Car-V/CSTAR-capstone/README.md

# CSTAR-capstone
Concrete Sounding Tool Automated Robot for EECE4792 Capstone 2
