Car-V/CSTAR-capstone/Software_Layout/High Level Overview.pdf

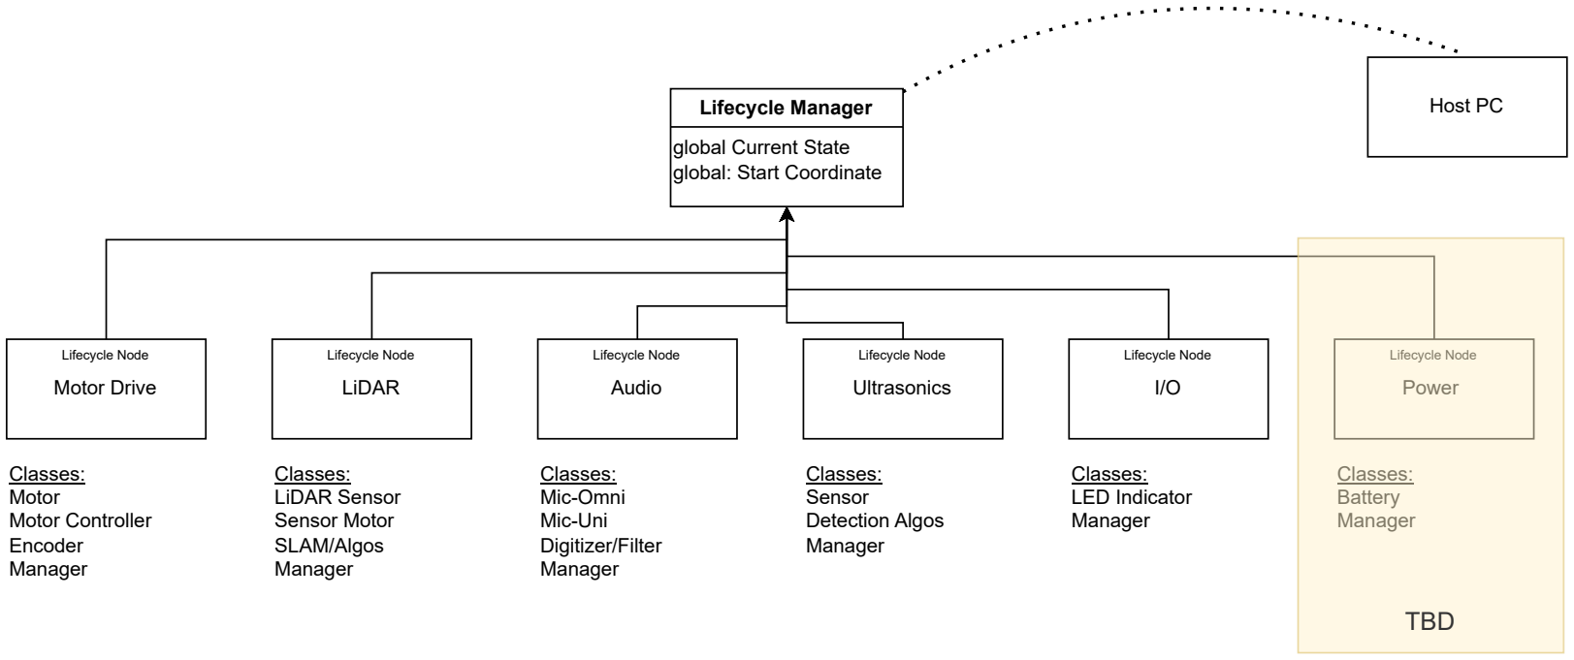
[picture p1: figure]
Motor Drive; LiDAR; Audio; Ultrasonics; Power; Lifecycle Manager; Host PC; global Current State global: Start Coordinate; Lifecycle Node; Classes: Motor Motor Controller Encoder Manager; Classes: LiDAR Sensor Sensor Motor SLAM/Algos Manager; Classes: Mic-Omni Mic-Uni Digitizer/Filter Manager; Classes: Sensor Detection Algos Manager; Classes: LED Indicator Manager; Classes: Battery Manager; TBD

# What Should All Subsystems Be Aware Of?

Current State (Possibly int with value of 1, 2, or 3?)

Starting Point Coordinates

Determined by:
Status of all subsystems
Network Connection
Connection with Host
