Car-V/CSTAR-capstone/Software_Layout/LiDAR/frames_2025-02-05_11.53.08.pdf

view_frames Result

Recorded at time: 1738774388.4656897

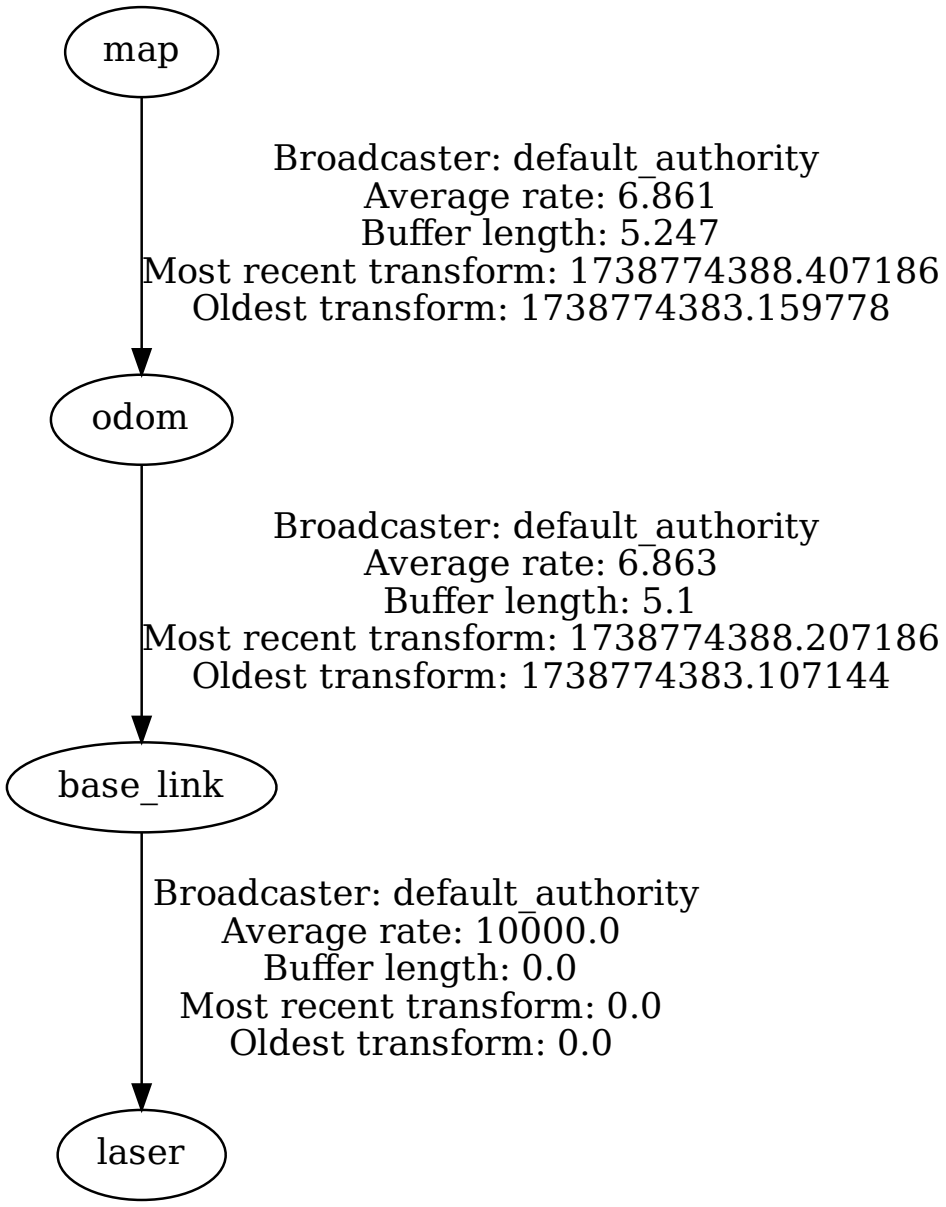
[picture p2: figure]
map; odom; Broadcaster: default_authority Average rate: 6.861 Buffer length: 5.247 Most recent transform: 1738774388.407186 Oldest transform: 1738774383.159778; base_link; Broadcaster: default_authority Average rate: 6.863 Buffer length: 5.1 Most recent transform: 1738774388.207186 Oldest transform: 1738774383.107144; laser; Broadcaster: default_authority Average rate: 10000.0 Buffer length: 0.0 Most recent transform: 0.0 Oldest transform: 0.0
