Car-V/CSTAR-capstone/Software_Layout/LiDAR/frames_2025-02-05_11.55.34.pdf

view_frames Result

Recorded at time: 1738774534.904796

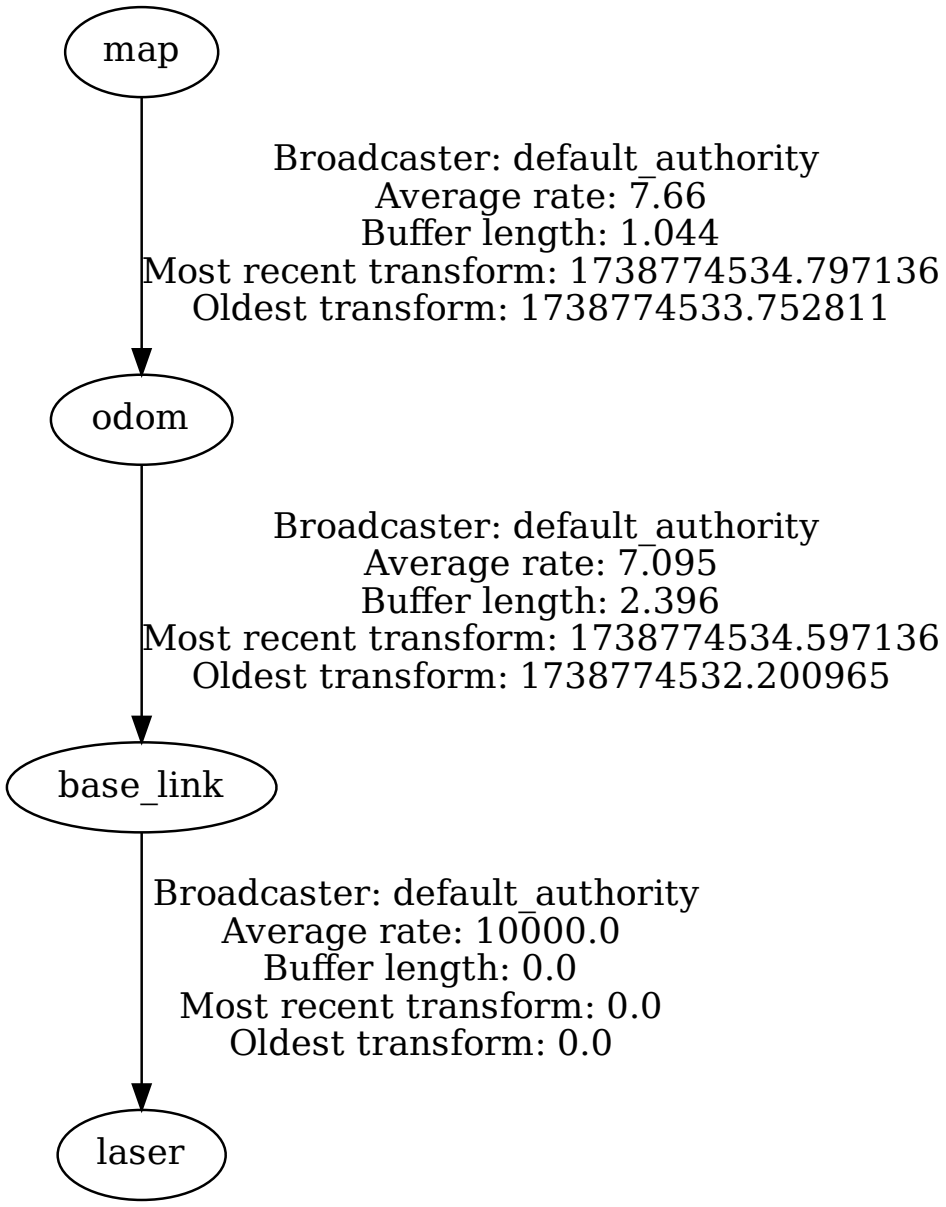
[picture p3: figure]
base_link; laser; Broadcaster: default_authority Average rate: 10000.0 Buffer length: 0.0 Most recent transform: 0.0 Oldest transform: 0.0; odom; Broadcaster: default_authority Average rate: 7.095 Buffer length: 2.396 Most recent transform: 1738774534.597136 Oldest transform: 1738774532.200965; map; Broadcaster: default_authority Average rate: 7.66 Buffer length: 1.044 Most recent transform: 1738774534.797136 Oldest transform: 1738774533.752811
