Car-V/CSTAR-capstone/PCB_Rev1/Main_Board_Rev1/Components/CAD/USB4125-GF-A_REVA2.step

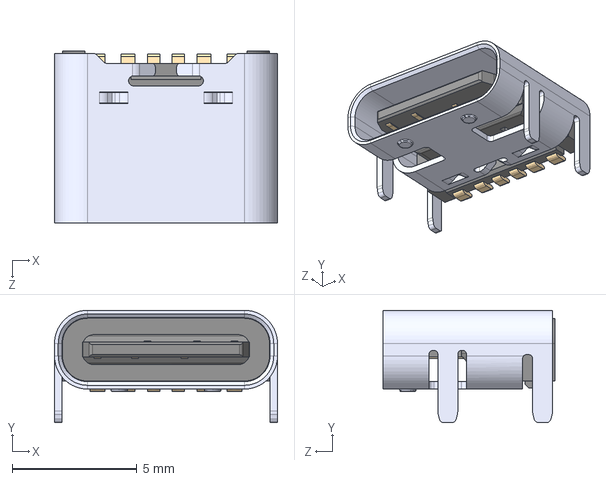
[picture p4: CAD file, 2025-01-22]
PCB_Rev1/Main_Board_Rev1/Components/CAD/USB4125-GF-A_REVA2.step
8.94 x 4.51 x 6.90 mm
