Car-V/CSTAR-capstone/PCB_Rev1/Main_Board_Rev1/Components/CAD/Omnidirectional.step

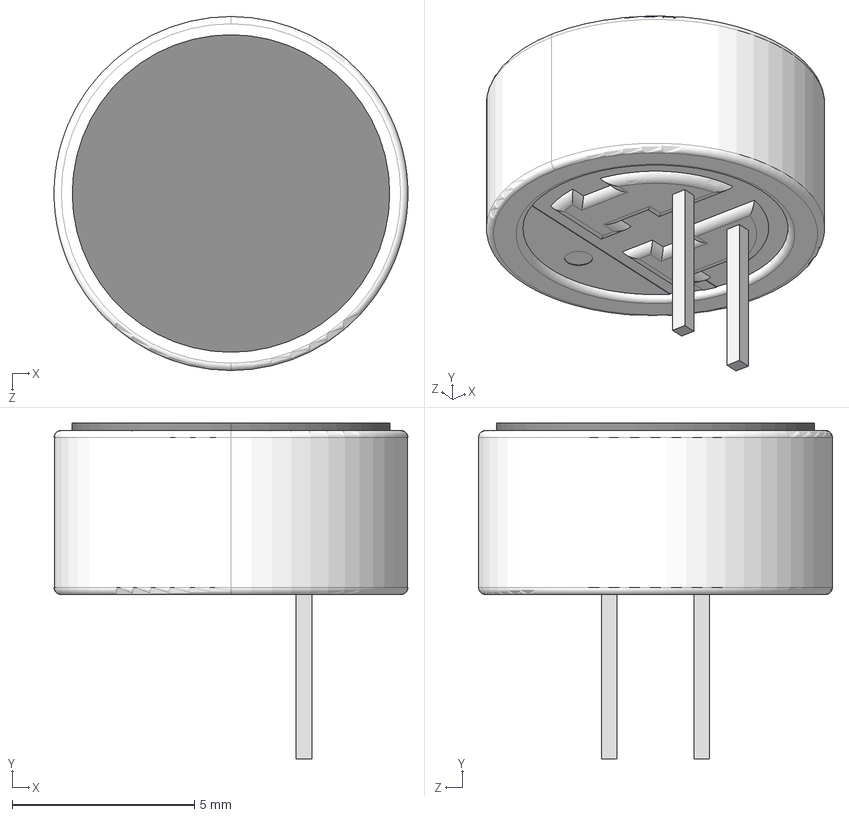
[picture p5: CAD file, 2025-01-15]
PCB_Rev1/Main_Board_Rev1/Components/CAD/Omnidirectional.step
9.70 x 9.20 x 9.70 mm
