Car-V/CSTAR-capstone/(list of files, cad)

Other CAD files:
PCB_Rev1/Components/CAD/Omnidirectional.step
