Car-V/CSTAR-capstone/JLC_ordering_Rev1_1-26/JLC_PCB_order_confirmation.pdf

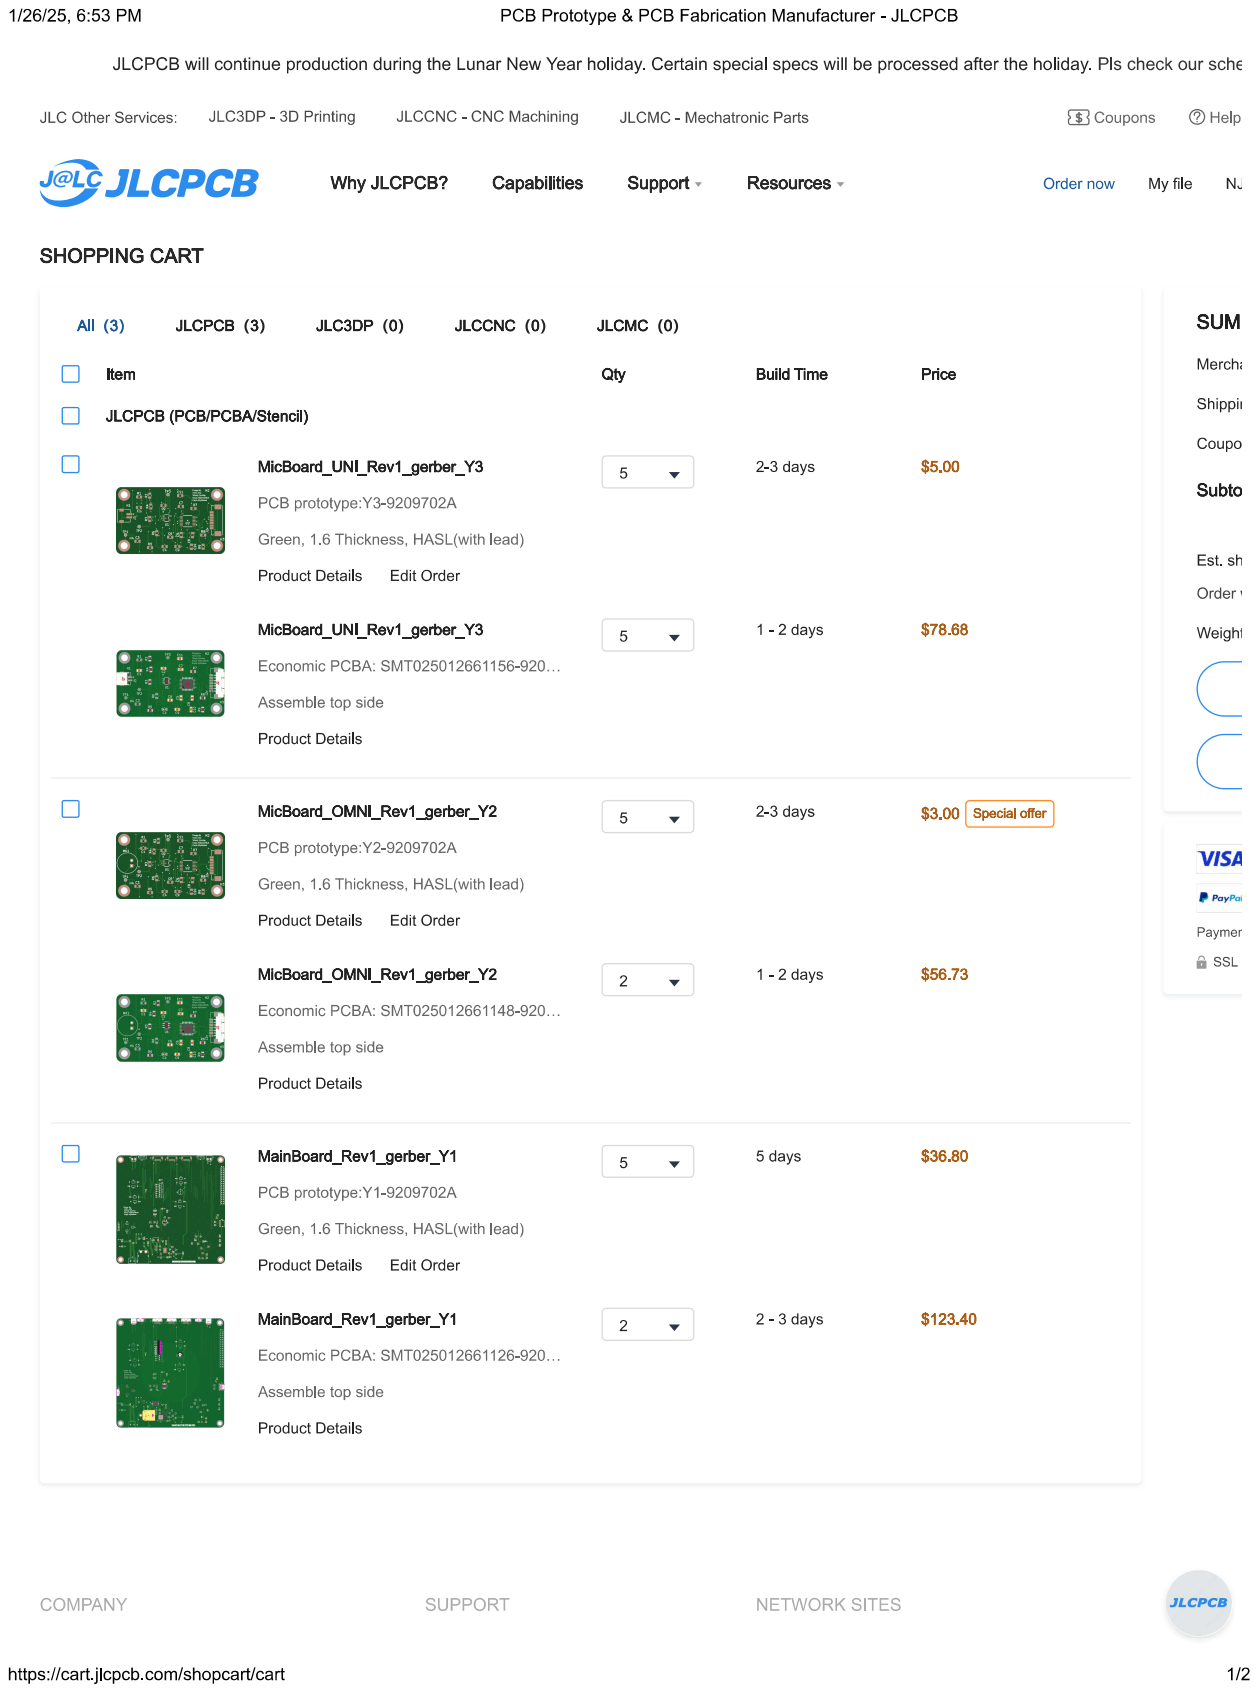
[picture p9: page 1]

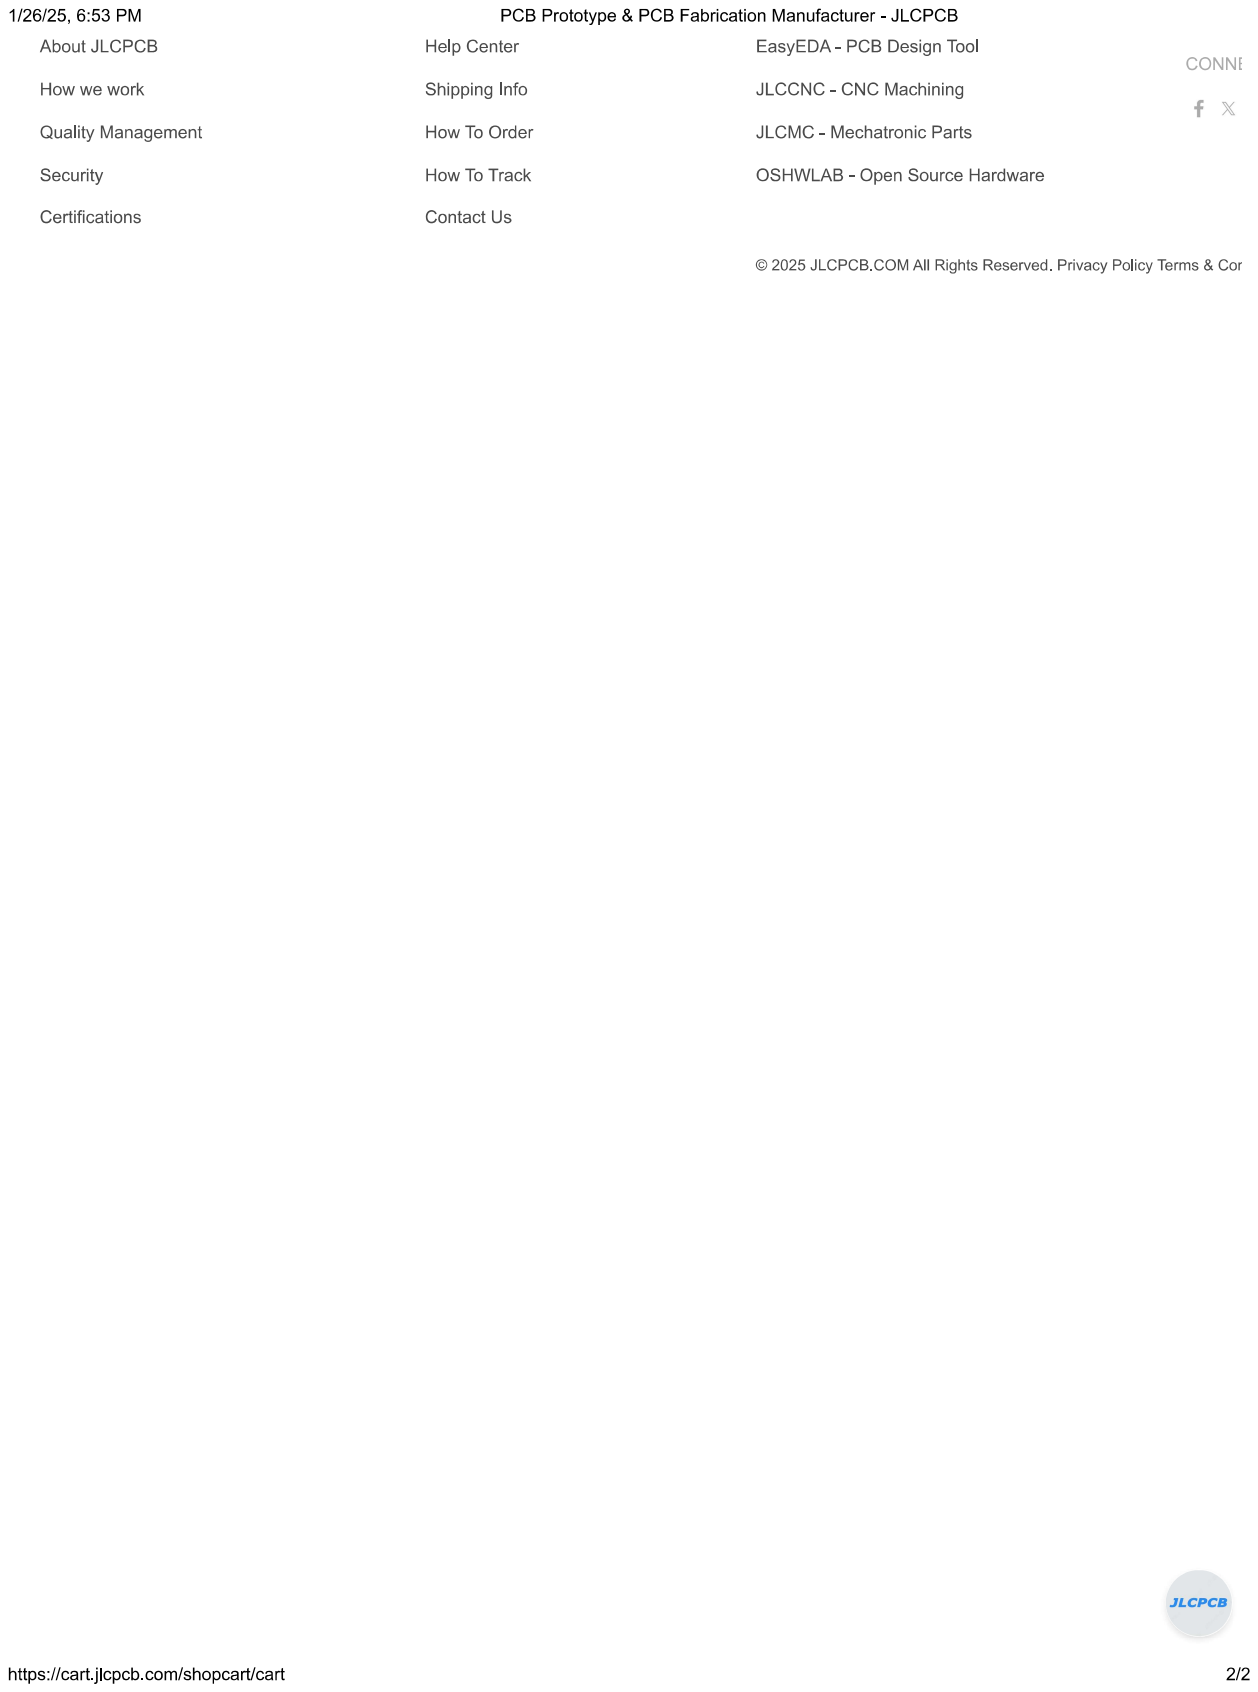
[picture p10: page 2]
