Car-V/CSTAR-capstone/PCB_Rev1/Mic_Board_Omni_NEW/Mic_Board_Omni_NEW.kicad_pcb

## KiCad design PCB_Rev1/Mic_Board_Omni_NEW/Mic_Board_Omni_NEW.kicad_pcb (2025-01-27)

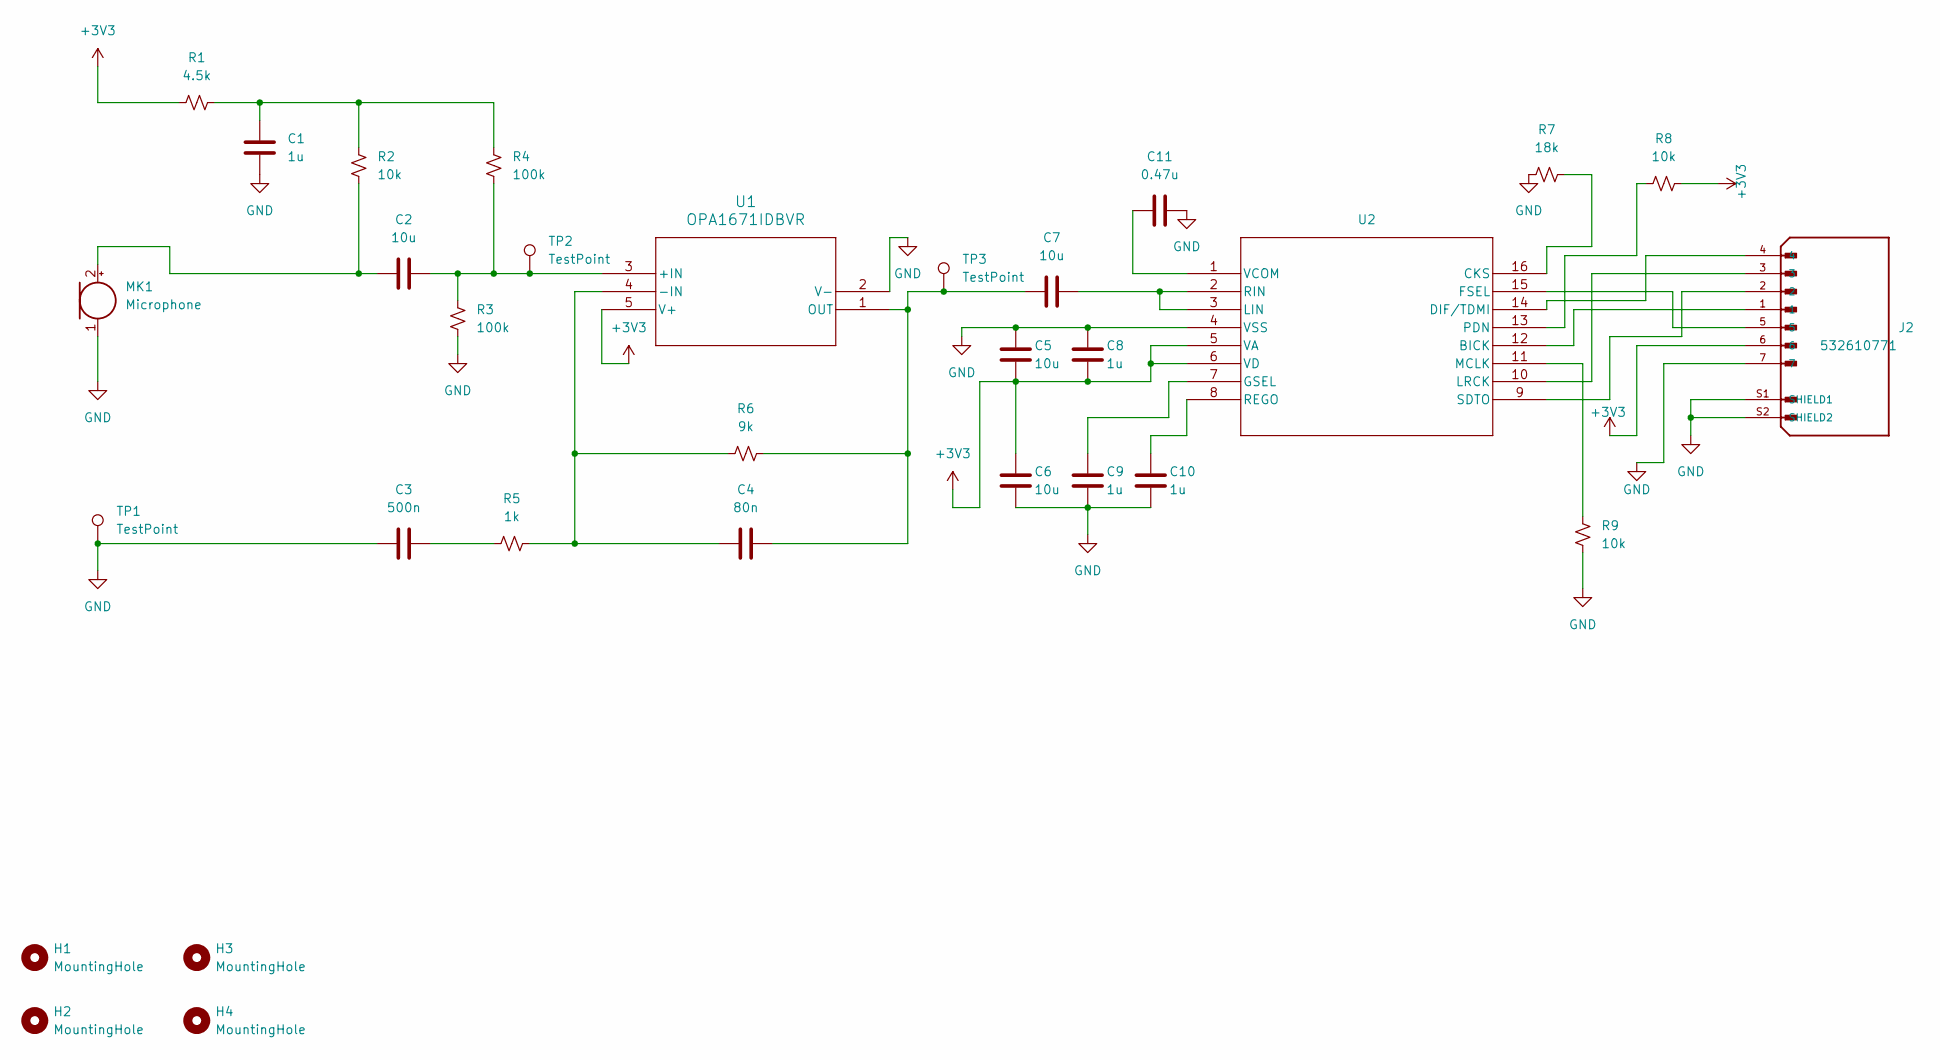
[picture p11: schematic Mic_Board_Omni_NEW.kicad_sch]

Parts:
C1, C8, C9, C10: 1u; C_0805_2012Metric; LCSC C519973
C2, C5, C6, C7: 10u; C_0805_2012Metric; LCSC C88484
C3: 500n; C_0805_2012Metric; LCSC C576434
C4: 80n; C_0805_2012Metric; LCSC C3857194
C11: 0.47u; C_0805_2012Metric; LCSC C519977
H1, H2, H3, H4: MountingHole; MountingHole_3.2mm_M3
J2: 532610771; MOLEX_connector; PARTREV J; DigiKey_Part_Number WM7625TR-ND
MK1: Microphone; Omnidirectional; LCSC C3273770
R1: 4.5k; R_0805_2012Metric; LCSC C865529
R2, R8, R9: 10k; R_0805_2012Metric; LCSC C110775
R3, R4: 100k; R_0805_2012Metric; LCSC C96346
R5: 1k; R_0805_2012Metric; LCSC C95781
R6: 9k; R_0805_2012Metric; LCSC C868262
R7: 18k; R_0805_2012Metric; LCSC C137468
TP1, TP2, TP3: TestPoint; TestPoint_Pad_D1.0mm
U1: OPA1671IDBVR; Op-Amp; LCSC C1849409
U2: ADC; LCSC C1519002

Connections:
+3V3: C5.2, C6.1, C8.2, J2.6, R1.2, R8.2, U1.5 (V+), U2.5 (VA), U2.6 (VD)
GND: C1.2, C3.1, C5.1, C6.2, C8.1, C9.2, C10.2, C11.2, H1.1, H2.1, H3.1, H4.1, J2.7, J2.S1 (SHIELD1), J2.S2 (SHIELD2), MK1.1 (-), R3.2, R7.1, R9.1, TP1.1, U1.2 (V-), U2.4 (VSS)
unnamed: C1.1, R1.1, R2.1, R4.1
unnamed: C3.2, R5.2
unnamed: C2.1, MK1.2 (+), R2.2
unnamed: C2.2, R3.1, R4.2, TP2.1, U1.3 (+IN)
unnamed: C4.1, R5.1, R6.2, U1.4 (-IN)
unnamed: C4.2, C7.1, R6.1, TP3.1, U1.1 (OUT)
unnamed: J2.1, U2.12 (BICK)
unnamed: R7.2, U2.16 (CKS)
unnamed: J2.4, U2.14 (DIF/TDMI)
unnamed: J2.5, U2.15 (FSEL)
unnamed: C9.1, U2.7 (GSEL)
unnamed: C7.2, U2.2 (RIN), U2.3 (LIN)
unnamed: J2.3, U2.10 (LRCK)
unnamed: R9.2, U2.11 (MCLK)
unnamed: R8.1, U2.13 (PDN)
unnamed: C10.1, U2.8 (REGO)
unnamed: J2.2, U2.9 (SDTO)
unnamed: C11.1, U2.1 (VCOM)

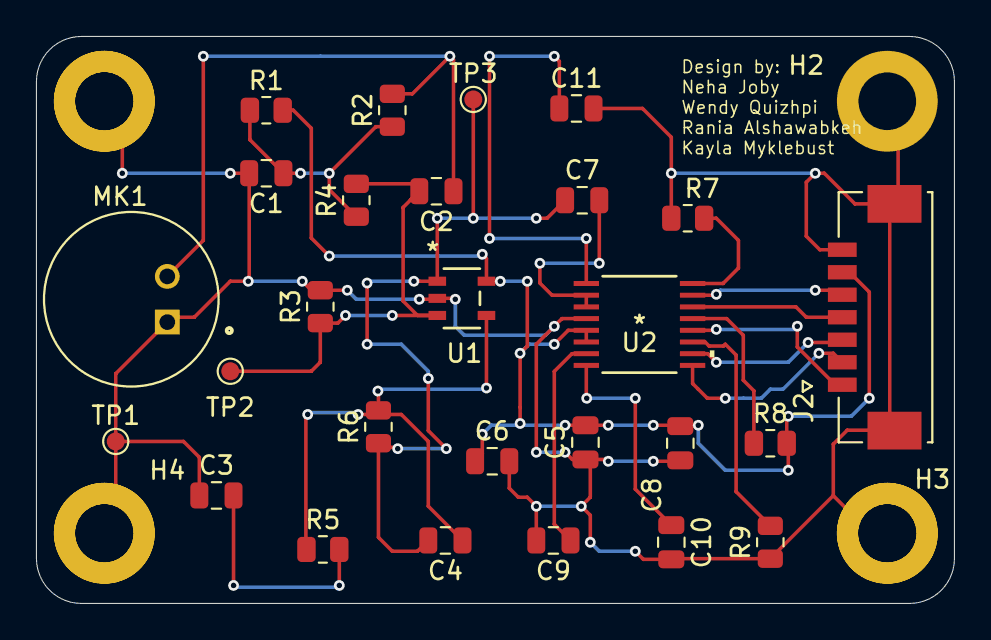
[picture p12: board Mic_Board_Omni_NEW.kicad_pcb from above]

Board: 2 copper layers, 51.0 x 31.5 mm, 31 parts (0 on the bottom side), 20 nets.
