Car-V/CSTAR-capstone/PCB_Rev1/Main_Board_Rev1/Main_Board_Rev1.kicad_pcb

## KiCad design PCB_Rev1/Main_Board_Rev1/Main_Board_Rev1.kicad_pcb (2025-01-26)

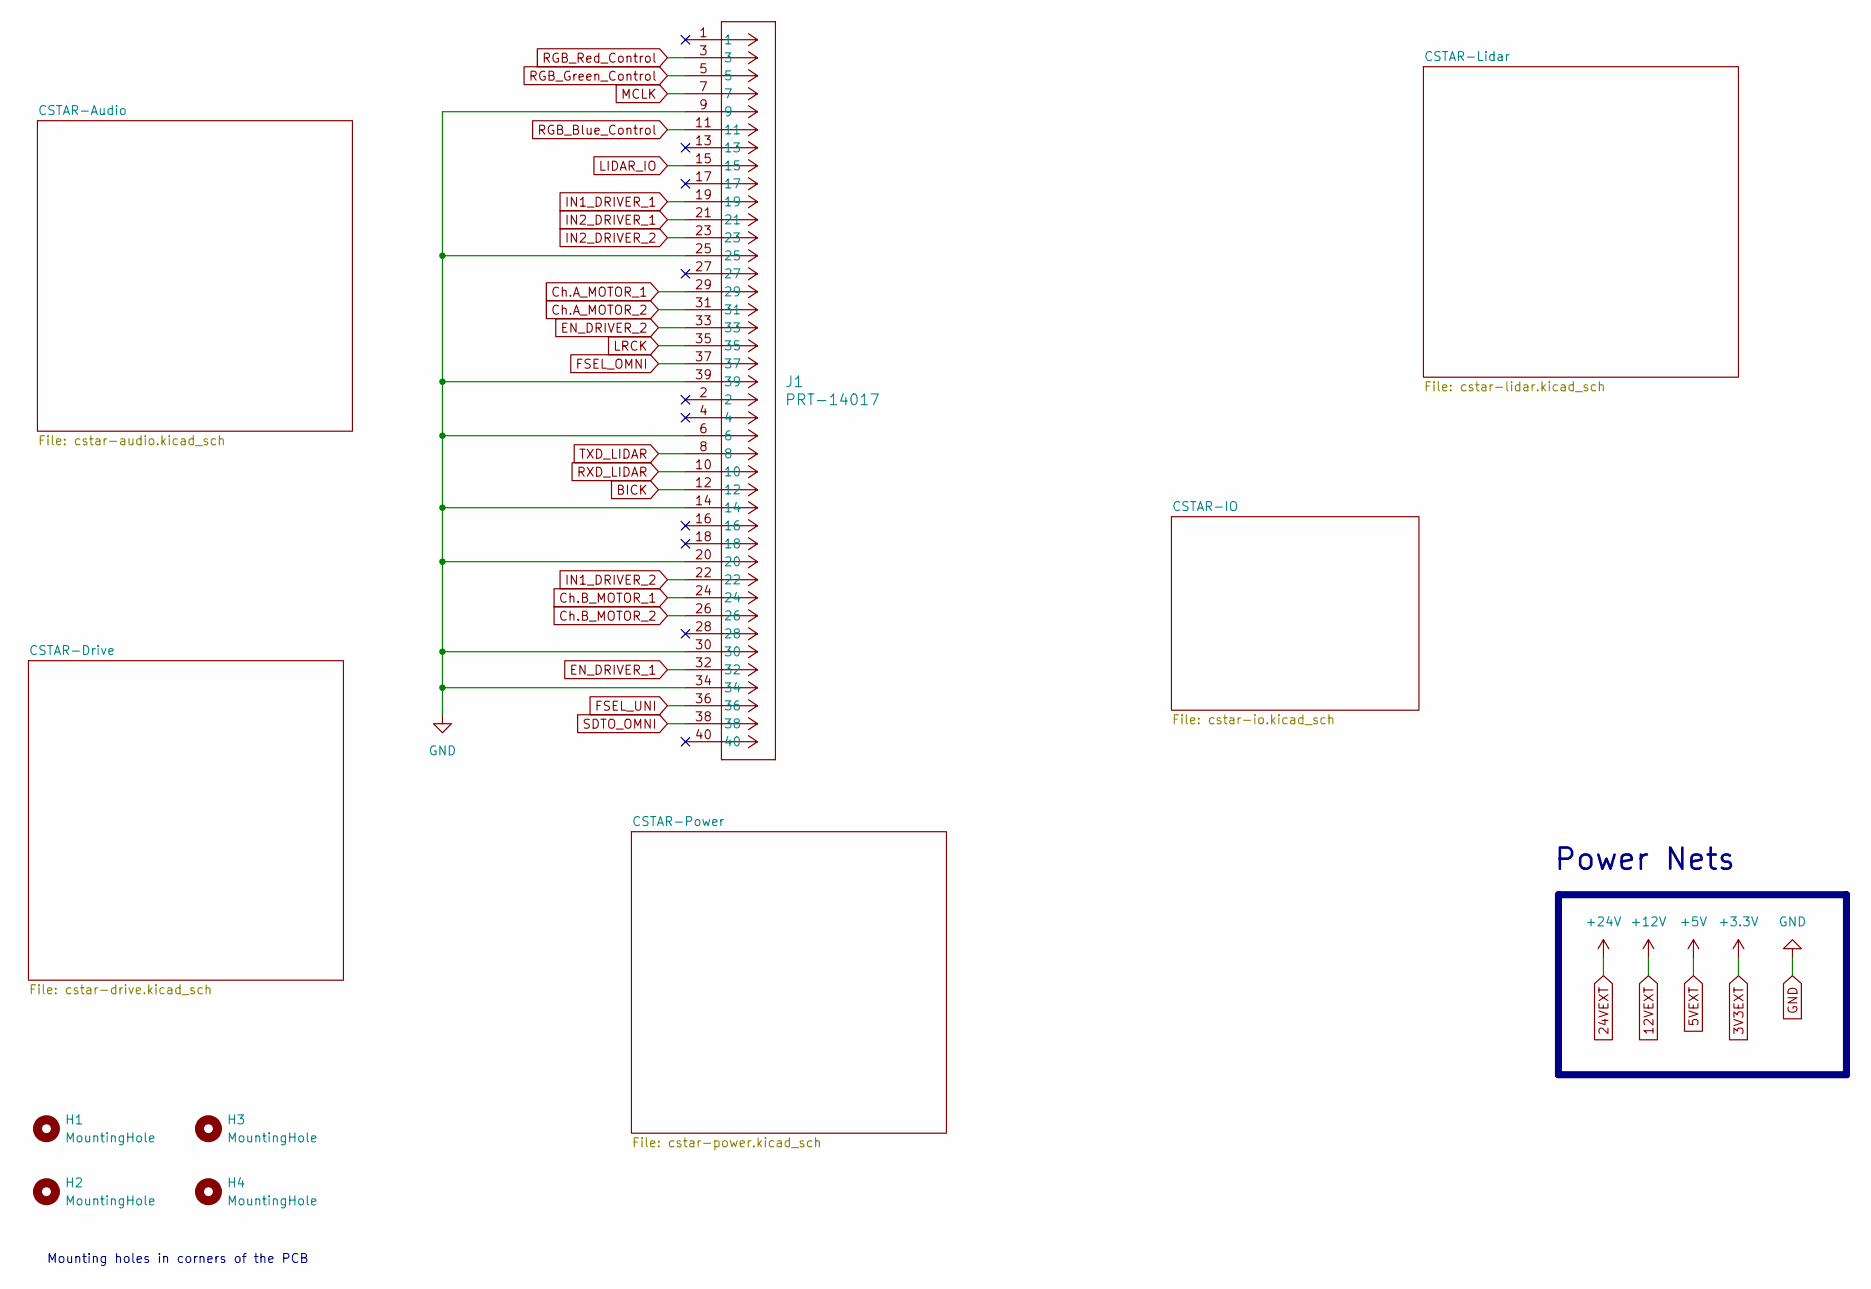
[picture p13: schematic Main_Board_Rev1.kicad_sch]

Parts:
H1, H2, H3, H4: MountingHole; MountingHole_5.3mm_M5_DIN965_Pad
J1: PRT-14017; RPiConnector; LCSC C2859067

Connections:
BICK: J1.12; also elsewhere on the board
Ch.A_MOTOR_1: J1.29; also elsewhere on the board
Ch.A_MOTOR_2: J1.31; also elsewhere on the board
Ch.B_MOTOR_1: J1.24; also elsewhere on the board
Ch.B_MOTOR_2: J1.26; also elsewhere on the board
EN_DRIVER_1: J1.32; also elsewhere on the board
EN_DRIVER_2: J1.33; also elsewhere on the board
FSEL_OMNI: J1.37; also elsewhere on the board
FSEL_UNI: J1.36; also elsewhere on the board
GND: J1.6, J1.9, J1.14, J1.20, J1.25, J1.30, J1.34, J1.39; also elsewhere on the board
IN1_DRIVER_1: J1.19; also elsewhere on the board
IN1_DRIVER_2: J1.22; also elsewhere on the board
IN2_DRIVER_1: J1.21; also elsewhere on the board
IN2_DRIVER_2: J1.23; also elsewhere on the board
LIDAR_IO: J1.15; also elsewhere on the board
LRCK: J1.35; also elsewhere on the board
MCLK: J1.7; also elsewhere on the board
RGB_Blue_Control: J1.11; also elsewhere on the board
RGB_Green_Control: J1.5; also elsewhere on the board
RGB_Red_Control: J1.3; also elsewhere on the board
RXD_LIDAR: J1.10; also elsewhere on the board
SDTO_OMNI: J1.38; also elsewhere on the board
TXD_LIDAR: J1.8; also elsewhere on the board

Notes on the sheet:
Power Nets
Mounting holes in corners of the PCB

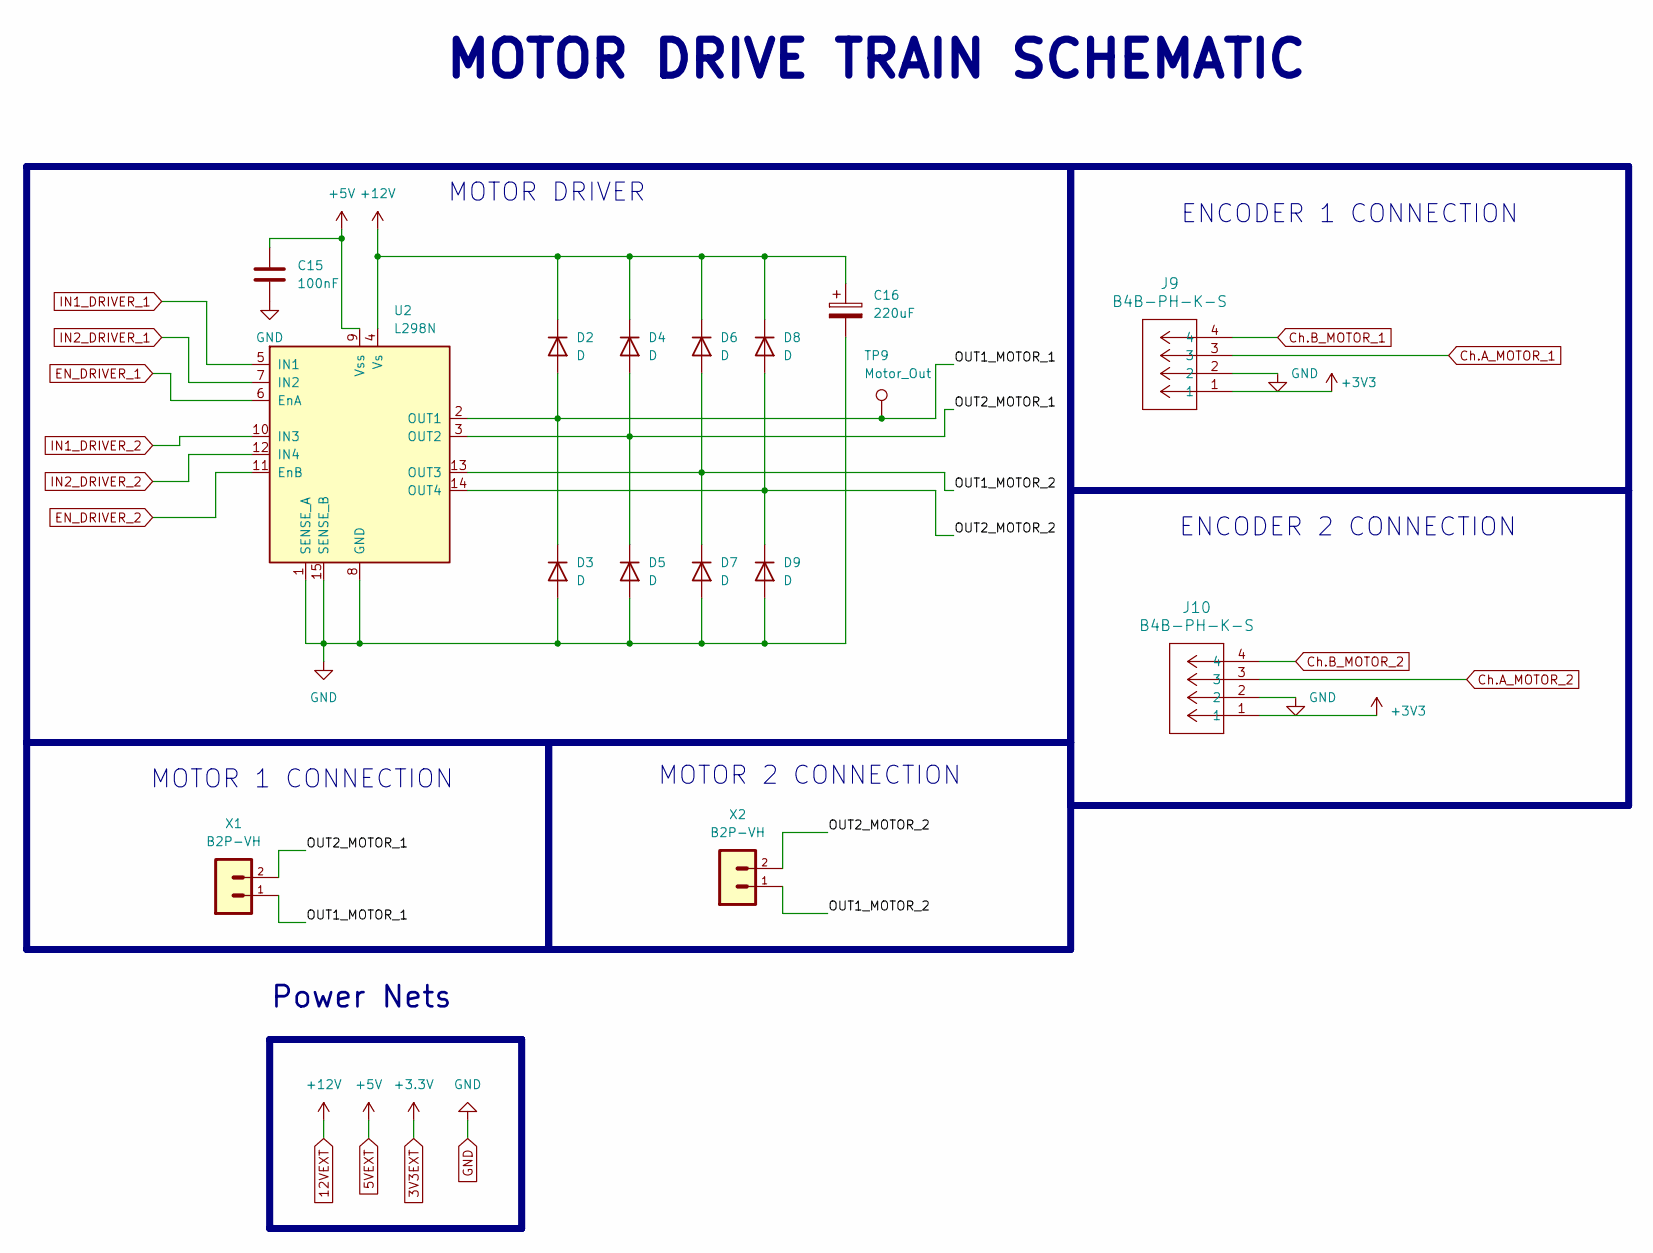
[picture p14: schematic cstar-drive.kicad_sch]

Parts:
C15: 100nF; C_0805_2012Metric; LCSC C520083
C16: 220uF; Cap_Polarized_220uF; LCSC C88729
D2, D3, D4, D5, D6, D7, D8, D9: D; Diode_1N4007; LCSC C516593
J9, J10: B4B-PH-K-S; B4B_PH_K_S; LCSC C305985
TP9: Motor_Out; TestPoint_Pad_D2.0mm
U2: L298N; TO-220-15_P2.54x2.54mm_StaggerOdd_Lead4.58mm_Vertical; LCSC C19922
X1, X2: B2P-VH; LCSC C160315

Connections:
5VEXT: C15.1, U2.9 (Vss); also elsewhere on the board
12VEXT: C16.1, D2.1 (K), D4.1 (K), D6.1 (K), D8.1 (K), U2.4 (Vs); also elsewhere on the board
+3V3: J9.1, J10.1; also elsewhere on the board
/CSTAR-Drive/OUT1_MOTOR_1: D2.2 (A), D3.1 (K), TP9.1, U2.2 (OUT1), X1.1
/CSTAR-Drive/OUT1_MOTOR_2: D6.2 (A), D7.1 (K), U2.13 (OUT3), X2.1
/CSTAR-Drive/OUT2_MOTOR_1: D4.2 (A), D5.1 (K), U2.3 (OUT2), X1.2
/CSTAR-Drive/OUT2_MOTOR_2: D8.2 (A), D9.1 (K), U2.14 (OUT4), X2.2
Ch.A_MOTOR_1: J9.3; also elsewhere on the board
Ch.A_MOTOR_2: J10.3; also elsewhere on the board
Ch.B_MOTOR_1: J9.4; also elsewhere on the board
Ch.B_MOTOR_2: J10.4; also elsewhere on the board
EN_DRIVER_1: U2.6 (EnA); also elsewhere on the board
EN_DRIVER_2: U2.11 (EnB); also elsewhere on the board
GND: C15.2, C16.2, D3.2 (A), D5.2 (A), D7.2 (A), D9.2 (A), J9.2, J10.2, U2.1 (SENSE_A), U2.8 (GND), U2.15 (SENSE_B); also elsewhere on the board
IN1_DRIVER_1: U2.5 (IN1); also elsewhere on the board
IN1_DRIVER_2: U2.10 (IN3); also elsewhere on the board
IN2_DRIVER_1: U2.7 (IN2); also elsewhere on the board
IN2_DRIVER_2: U2.12 (IN4); also elsewhere on the board

Notes on the sheet:
MOTOR 2 CONNECTION
Power Nets
MOTOR 1 CONNECTION
MOTOR DRIVER
ENCODER 1 CONNECTION
ENCODER 2 CONNECTION
MOTOR DRIVE TRAIN SCHEMATIC

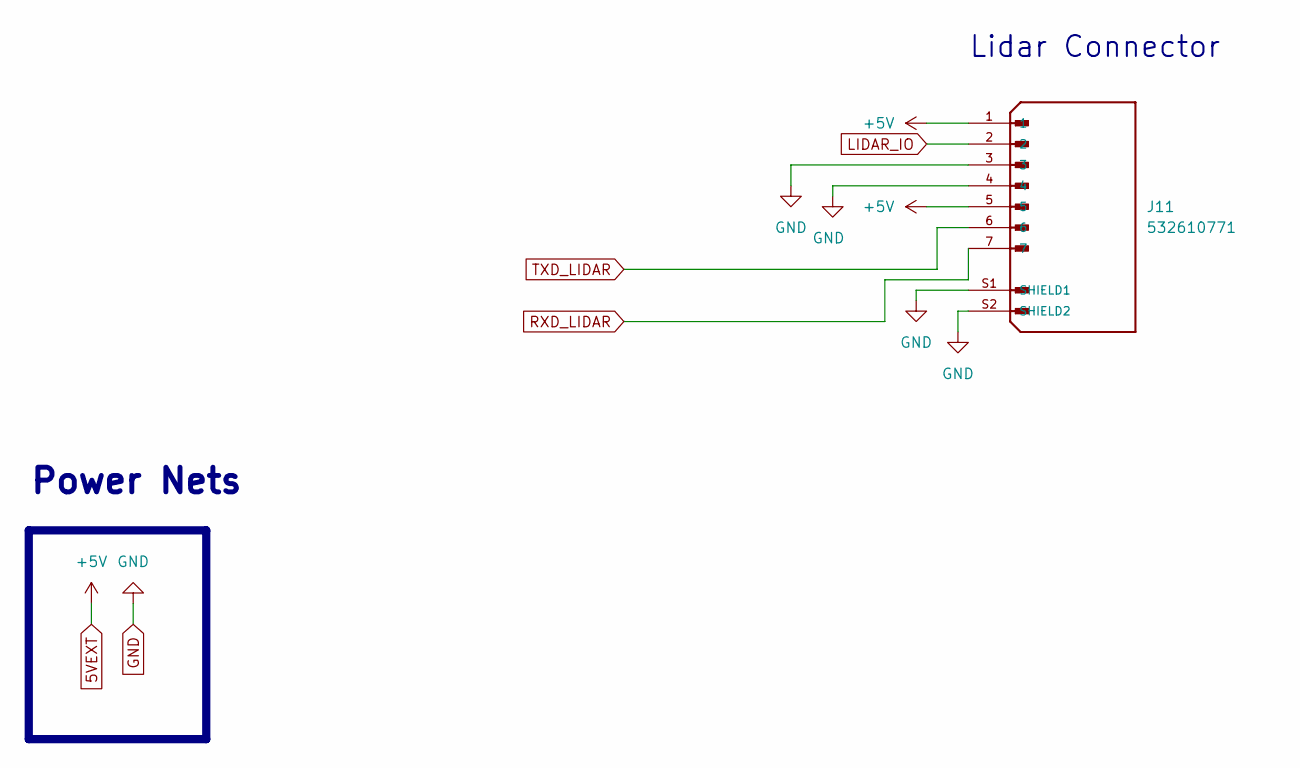
[picture p15: schematic cstar-lidar.kicad_sch]

Parts:
J11: 532610771; MOLEX_connector; PARTREV J; DigiKey_Part_Number WM7625TR-ND

Connections:
5VEXT: J11.1, J11.5; also elsewhere on the board
GND: J11.3, J11.4, J11.S1 (SHIELD1), J11.S2 (SHIELD2); also elsewhere on the board
LIDAR_IO: J11.2; also elsewhere on the board
RXD_LIDAR: J11.7; also elsewhere on the board
TXD_LIDAR: J11.6; also elsewhere on the board

Notes on the sheet:
Lidar Connector
Power Nets

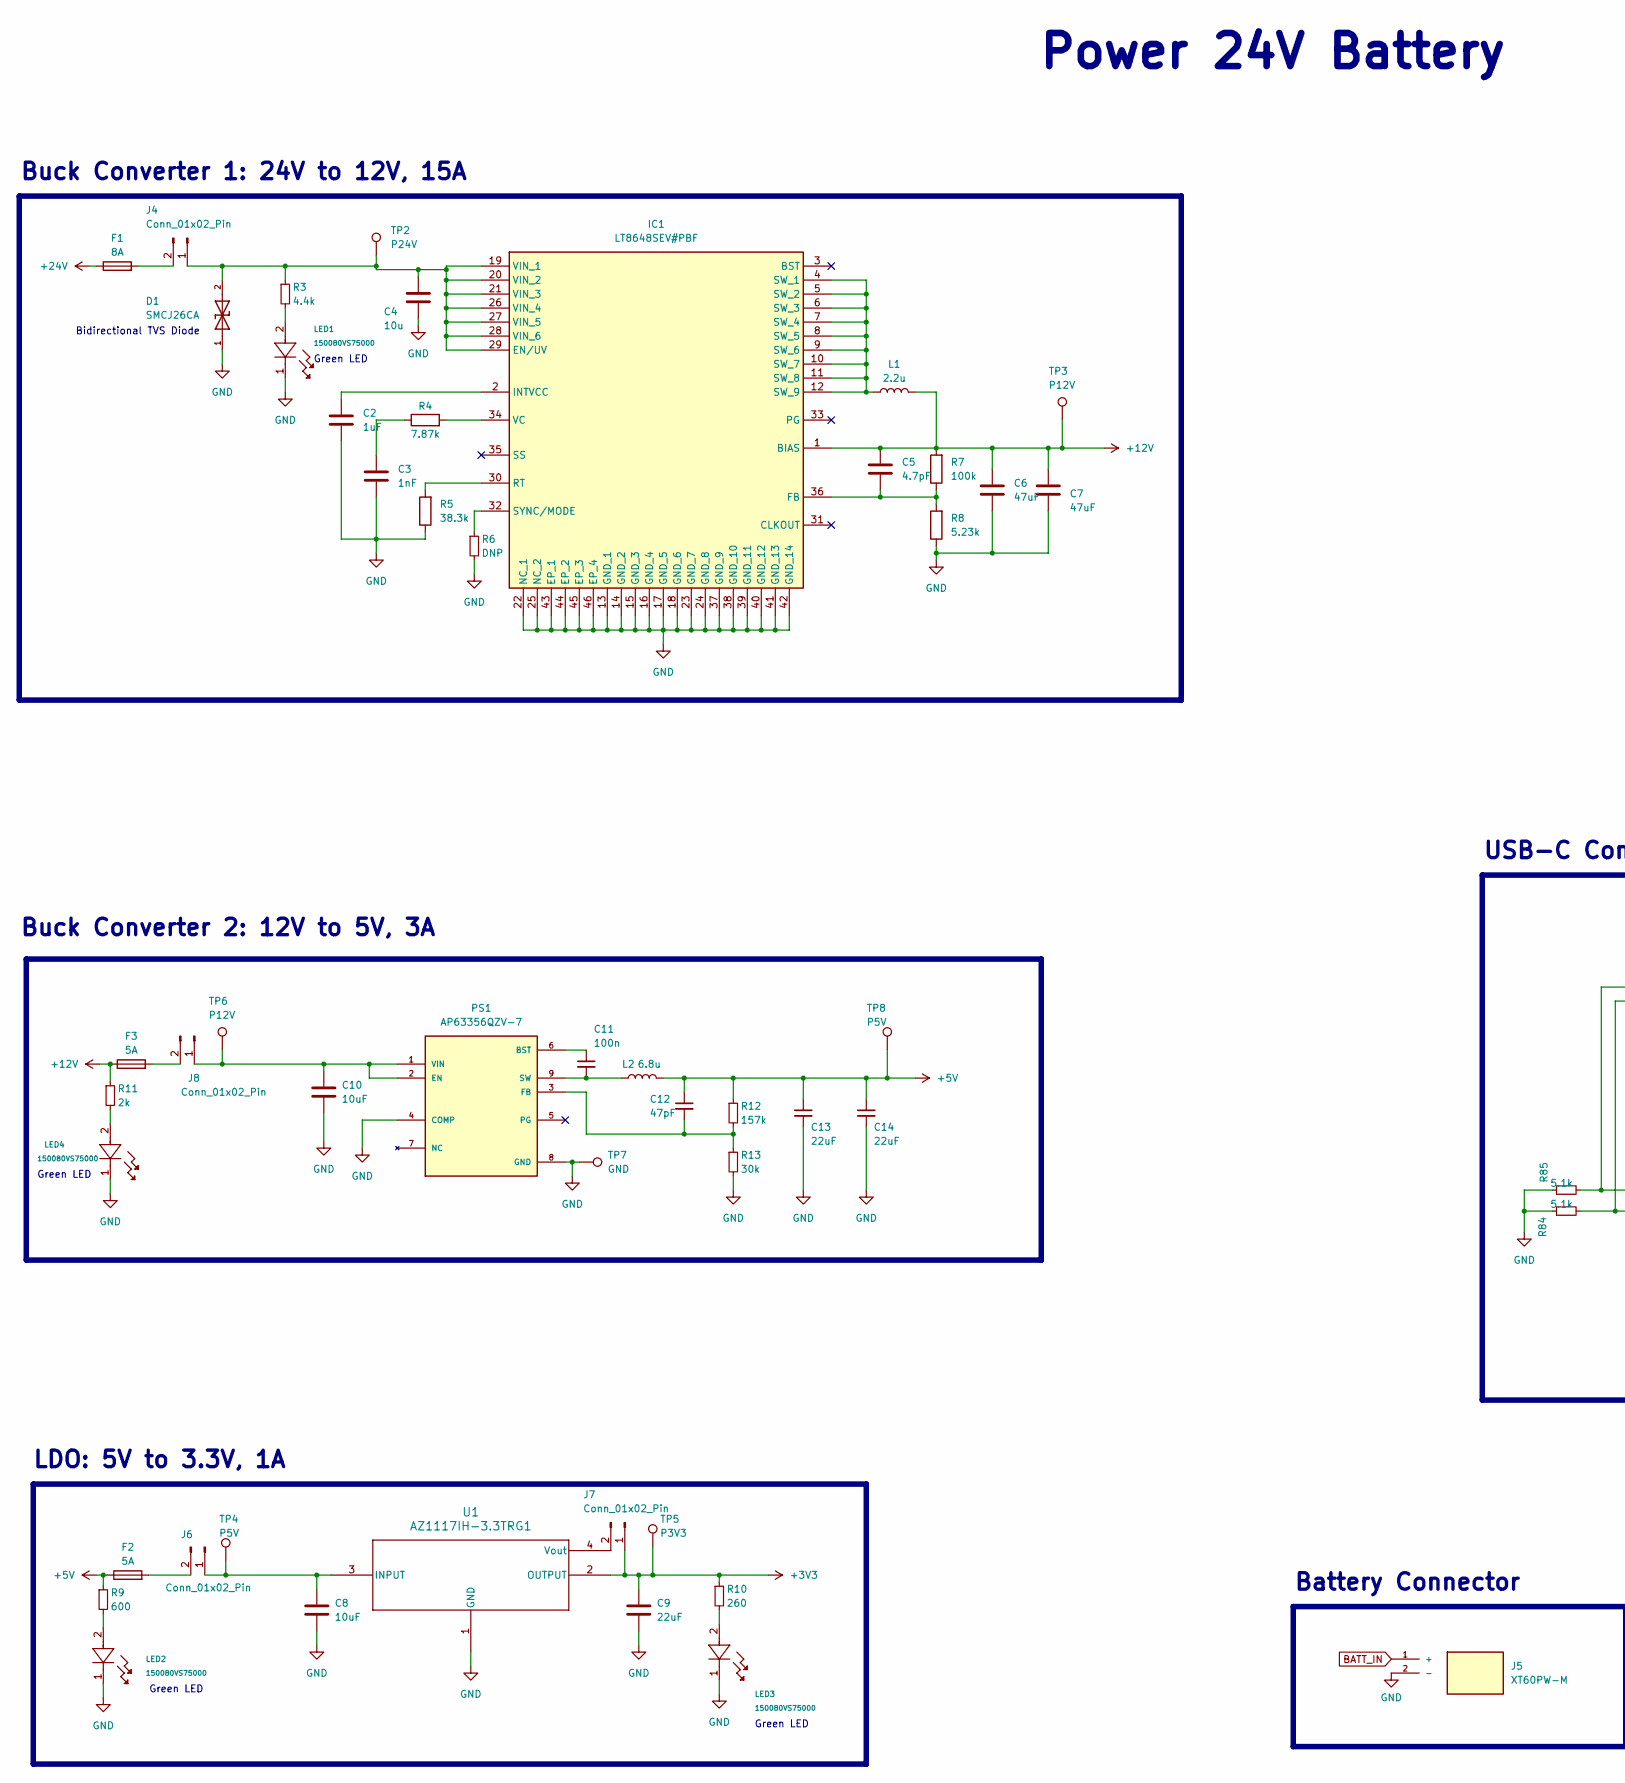
[picture p16: schematic cstar-power.kicad_sch, part in row 1, column 1]

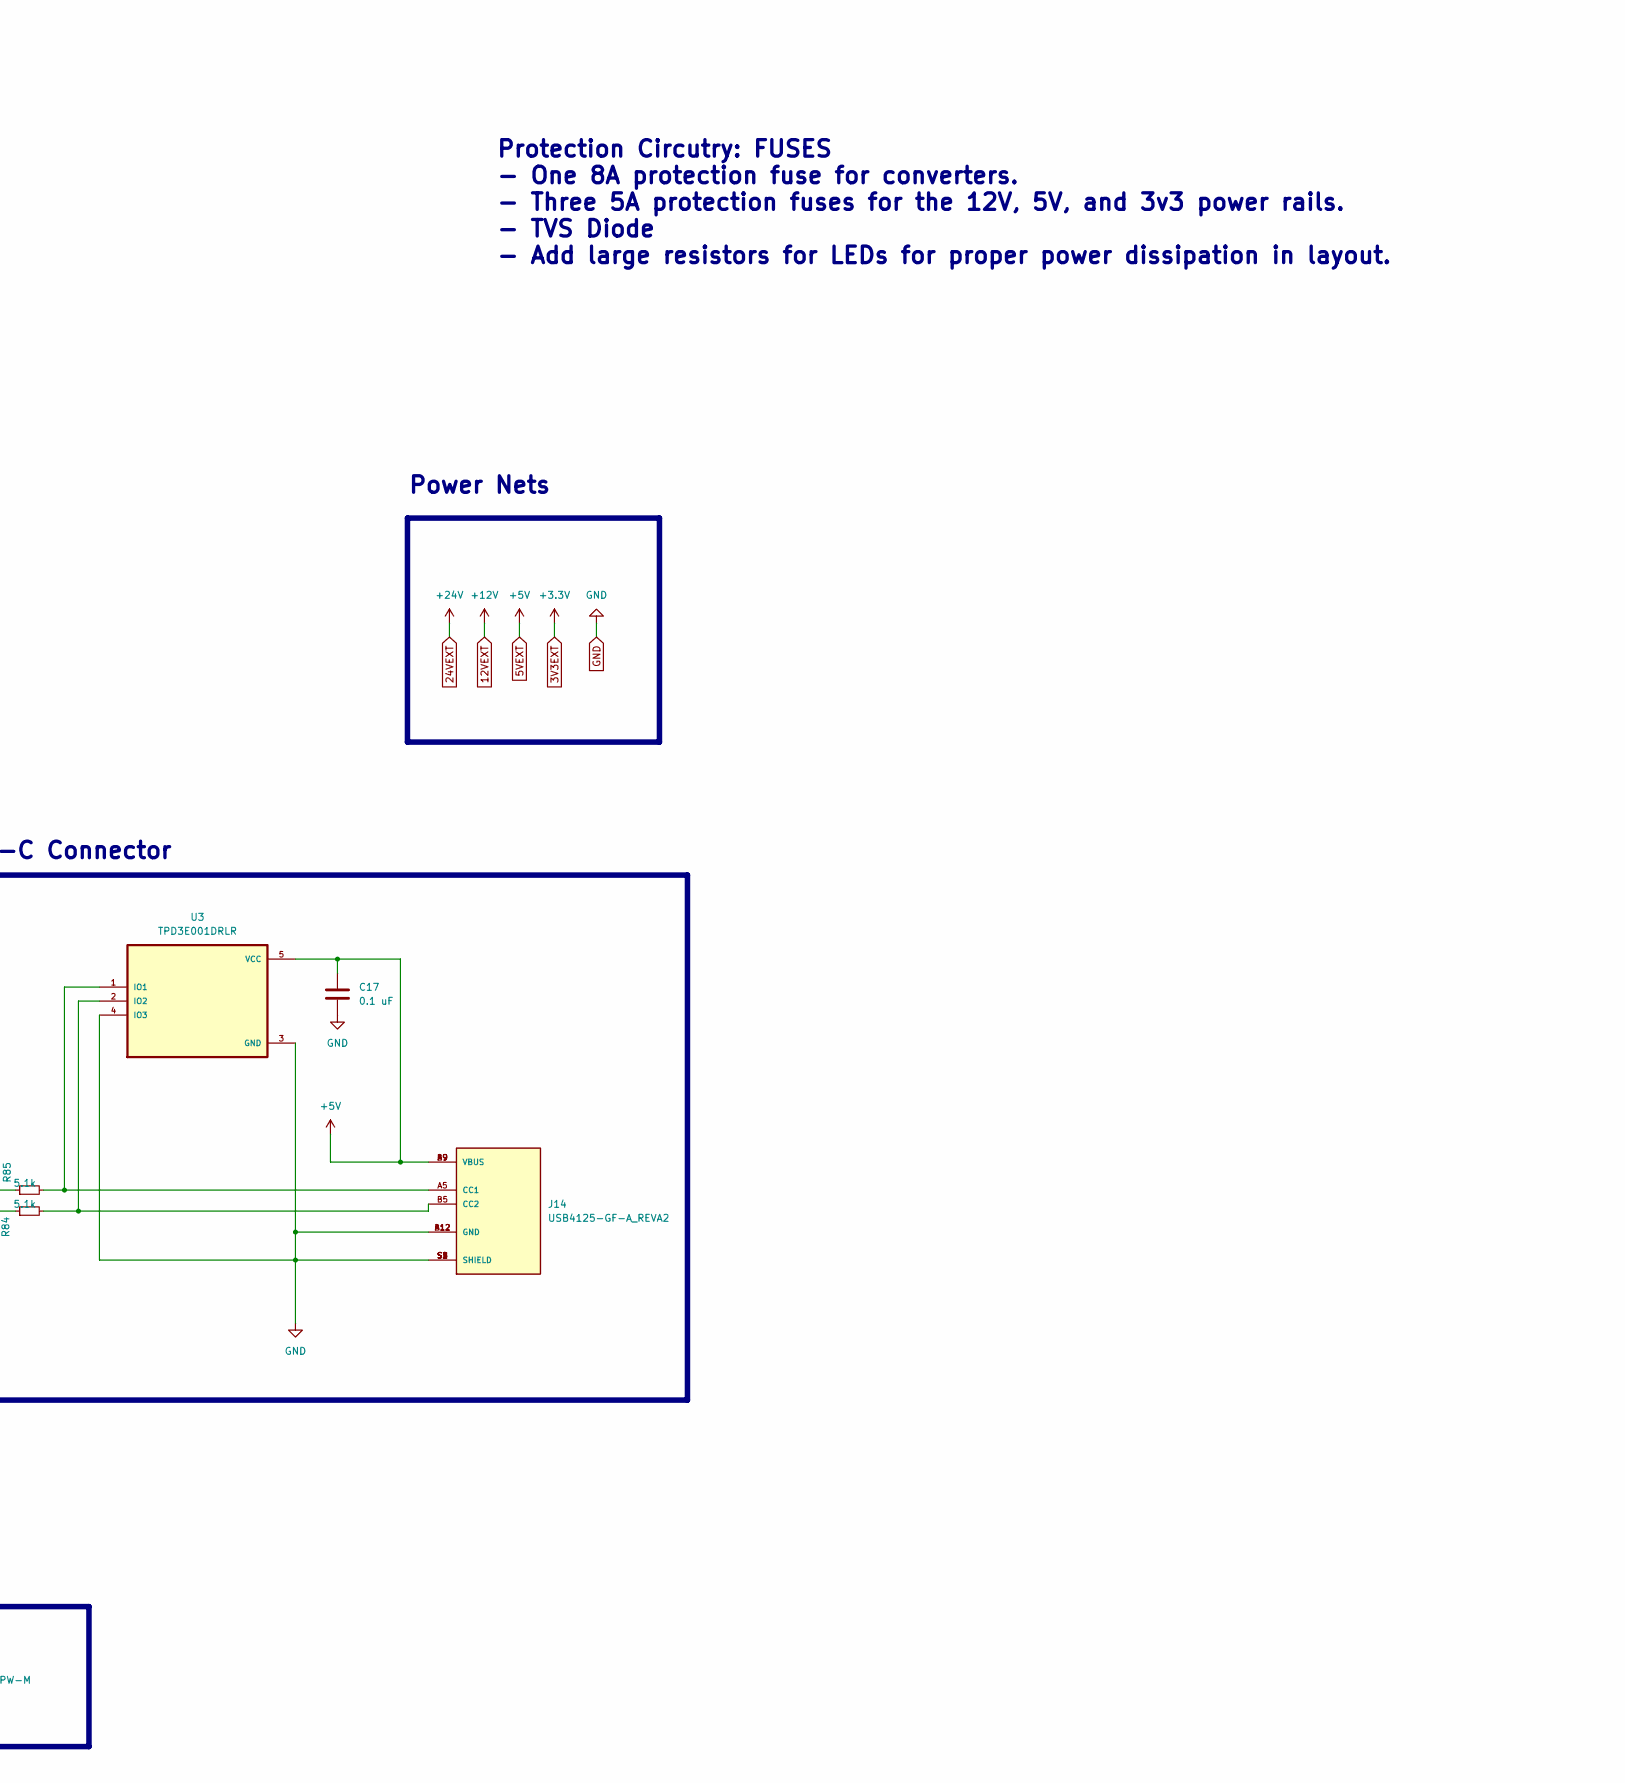
[picture p17: schematic cstar-power.kicad_sch, part in row 1, column 2]

Parts:
C2: 1uF; C_0805_2012Metric; LCSC C116352
C3: 1nF; C_0805_2012Metric; LCSC C2167084
C4: 10u; C_0805_2012Metric; LCSC C2190942
C5: 4.7pF; C_0805_2012Metric; LCSC C527074
C6, C7: 47uF; C_1206_3216Metric; LCSC C2167787
C8, C10: 10uF; C_0805_2012Metric; LCSC C2190942
C9, C13, C14: 22uF; C_0805_2012Metric; LCSC C602037
C11: 100n; C_0805_2012Metric; LCSC C49678
C12: 47pF; C_0805_2012Metric; LCSC C107118
C17: 0.1 uF; C_0805_2012Metric; LCSC C49678
D1: SMCJ26CA; D1_Bi-dir; PARTREV 11/20/15; LCSC C151280
F1: 8A; Fuse_0805_2012Metric; LCSC C3158319
F2, F3: 5A; Fuse_0805_2012Metric; LCSC C3159342
IC1: LT8648SEV#PBF; Buck_1; Mouser Part Number 584-LT8648SEV#PBF
J4, J6, J7, J8: Conn_01x02_Pin; PinHeader_1x02_P2.54mm_Vertical; LCSC C5828287
J5: XT60PW-M; AMASS_XT60PW-M_1x02_P7.20mm_Horizontal; LCSC C98732
J14: USB4125-GF-A_REVA2; GCT_USB4125-GF-A_REVA2; PARTREV Rev A2; LCSC C5246813
L1: 2.2u; L_0805_2012Metric; LCSC C540967
L2: 6.8u; L_0805_2012Metric; LCSC C844992
LED1, LED2, LED3, LED4: 150080VS75000; LED_0805_2012Metric
PS1: AP63356QZV-7; Buck_2; PARTREV 1-2; LCSC C3194571
R3: 4.4k; R_0805_2012Metric; LCSC C273997
R4: 7.87k; R_0805_2012Metric; LCSC C273910
R5: 38.3k; R_0805_2012Metric; LCSC C273970
R6: DNP; R_0805_2012Metric
R7: 100k; R_0805_2012Metric; LCSC C96346
R8: 5.23k; R_0805_2012Metric; LCSC C274009
R9: 600; R_0805_2012Metric; LCSC C137416
R10: 260; R_0805_2012Metric; LCSC C483083
R11: 2k; R_0805_2012Metric; LCSC C273808
R12: 157k; R_0805_2012Metric; LCSC C273954
R13: 30k; R_0805_2012Metric; LCSC C126352
R84, R85: 5.1k; R_0805_2012Metric; LCSC C105874
TP2: P24V; TestPoint_Pad_D2.0mm
TP3, TP6: P12V; TestPoint_Pad_D2.0mm
TP4, TP8: P5V; TestPoint_Pad_D2.0mm
TP5: P3V3; TestPoint_Pad_D2.0mm
TP7: GND; TestPoint_Pad_D2.0mm
U1: AZ1117IH-3.3TRG1; LDO; LCSC C108495
U3: TPD3E001DRLR; USBC_ESD_Protection; LCSC C470828

Connections:
5VEXT: C12.1, C13.1, C14.1, C17.1, F2.1, J14.A9 (VBUS), J14.B9 (VBUS), L2.2, R9.1, R12.1, TP8.1, U3.5 (VCC); also elsewhere on the board
12VEXT: C5.1, C6.1, C7.1, F3.1, IC1.1 (BIAS), L1.2, R7.2, R11.1, TP3.1; also elsewhere on the board
24VEXT: F1.1; also elsewhere on the board
+3V3: C9.1, J7.1, R10.1, TP5.1, U1.2 (OUTPUT); also elsewhere on the board
BATT_IN: J5.1 (+); also elsewhere on the board
GND: C2.2, C3.2, C4.2, C6.2, C7.2, C8.2, C9.2, C10.2, C13.2, C14.2, C17.2, D1.1, IC1.13 (GND_1), IC1.14 (GND_2), IC1.15 (GND_3), IC1.16 (GND_4), IC1.17 (GND_5), IC1.18 (GND_6), IC1.22 (NC_1), IC1.23 (GND_7), IC1.24 (GND_8), IC1.25 (NC_2), IC1.37 (GND_9), IC1.38 (GND_10), IC1.39 (GND_11), IC1.40 (GND_12), IC1.41 (GND_13), IC1.42 (GND_14), IC1.43 (EP_1), IC1.44 (EP_2), IC1.45 (EP_3), IC1.46 (EP_4), J5.2 (-), J14.A12 (GND), J14.B12 (GND), J14.S1 (SHIELD), J14.S2 (SHIELD), J14.S3 (SHIELD), J14.S4 (SHIELD), LED1.1, LED2.1, LED3.1, LED4.1, PS1.4 (COMP), PS1.8 (GND), R5.1, R6.2, R8.1, R13.2, R84.1, R85.1, TP7.1, U1.1 (GND), U3.3 (GND), U3.4 (IO3); also elsewhere on the board
unnamed: C3.1, R4.1
unnamed: C4.1, D1.2, IC1.19 (VIN_1), IC1.20 (VIN_2), IC1.21 (VIN_3), IC1.26 (VIN_4), IC1.27 (VIN_5), IC1.28 (VIN_6), IC1.29 (EN/UV), J4.1, R3.1, TP2.1
unnamed: C5.2, IC1.36 (FB), R7.1, R8.2
unnamed: C2.1, IC1.2 (INTVCC)
unnamed: IC1.30 (RT), R5.2
unnamed: IC1.4 (SW_1), IC1.5 (SW_2), IC1.6 (SW_3), IC1.7 (SW_4), IC1.8 (SW_5), IC1.9 (SW_6), IC1.10 (SW_7), IC1.11 (SW_8), IC1.12 (SW_9), L1.1
unnamed: IC1.32 (SYNC/MODE), R6.1
unnamed: IC1.34 (VC), R4.2
unnamed: F1.2, J4.2
unnamed: C8.1, J6.1, TP4.1, U1.3 (INPUT)
unnamed: F2.2, J6.2
unnamed: J7.2, U1.4 (Vout)
unnamed: C10.1, J8.1, PS1.1 (VIN), PS1.2 (EN), TP6.1
unnamed: F3.2, J8.2
unnamed: J14.A5 (CC1), R85.2, U3.1 (IO1)
unnamed: J14.B5 (CC2), R84.2, U3.2 (IO2)
unnamed: LED1.2, R3.2
unnamed: LED2.2, R9.2
unnamed: LED3.2, R10.2
unnamed: LED4.2, R11.2
unnamed: C11.1, PS1.6 (BST)
unnamed: C12.2, PS1.3 (FB), R12.2, R13.1
unnamed: C11.2, L2.1, PS1.9 (SW)

Notes on the sheet:
Power Nets
Green LED
LDO: 5V to 3.3V, 1A
Protection Circutry: FUSES - One 8A protection fuse for converters. - Three 5A protection fuses for the 12V, 5V, and 3v3 power rails. - TVS Diode - Add large resistors for LEDs for proper power dissipation in layout.
Bidirectional TVS Diode
Battery Connector
Power 24V Battery
Buck Converter 2: 12V to 5V, 3A
USB-C Connector
Buck Converter 1: 24V to 12V, 15A

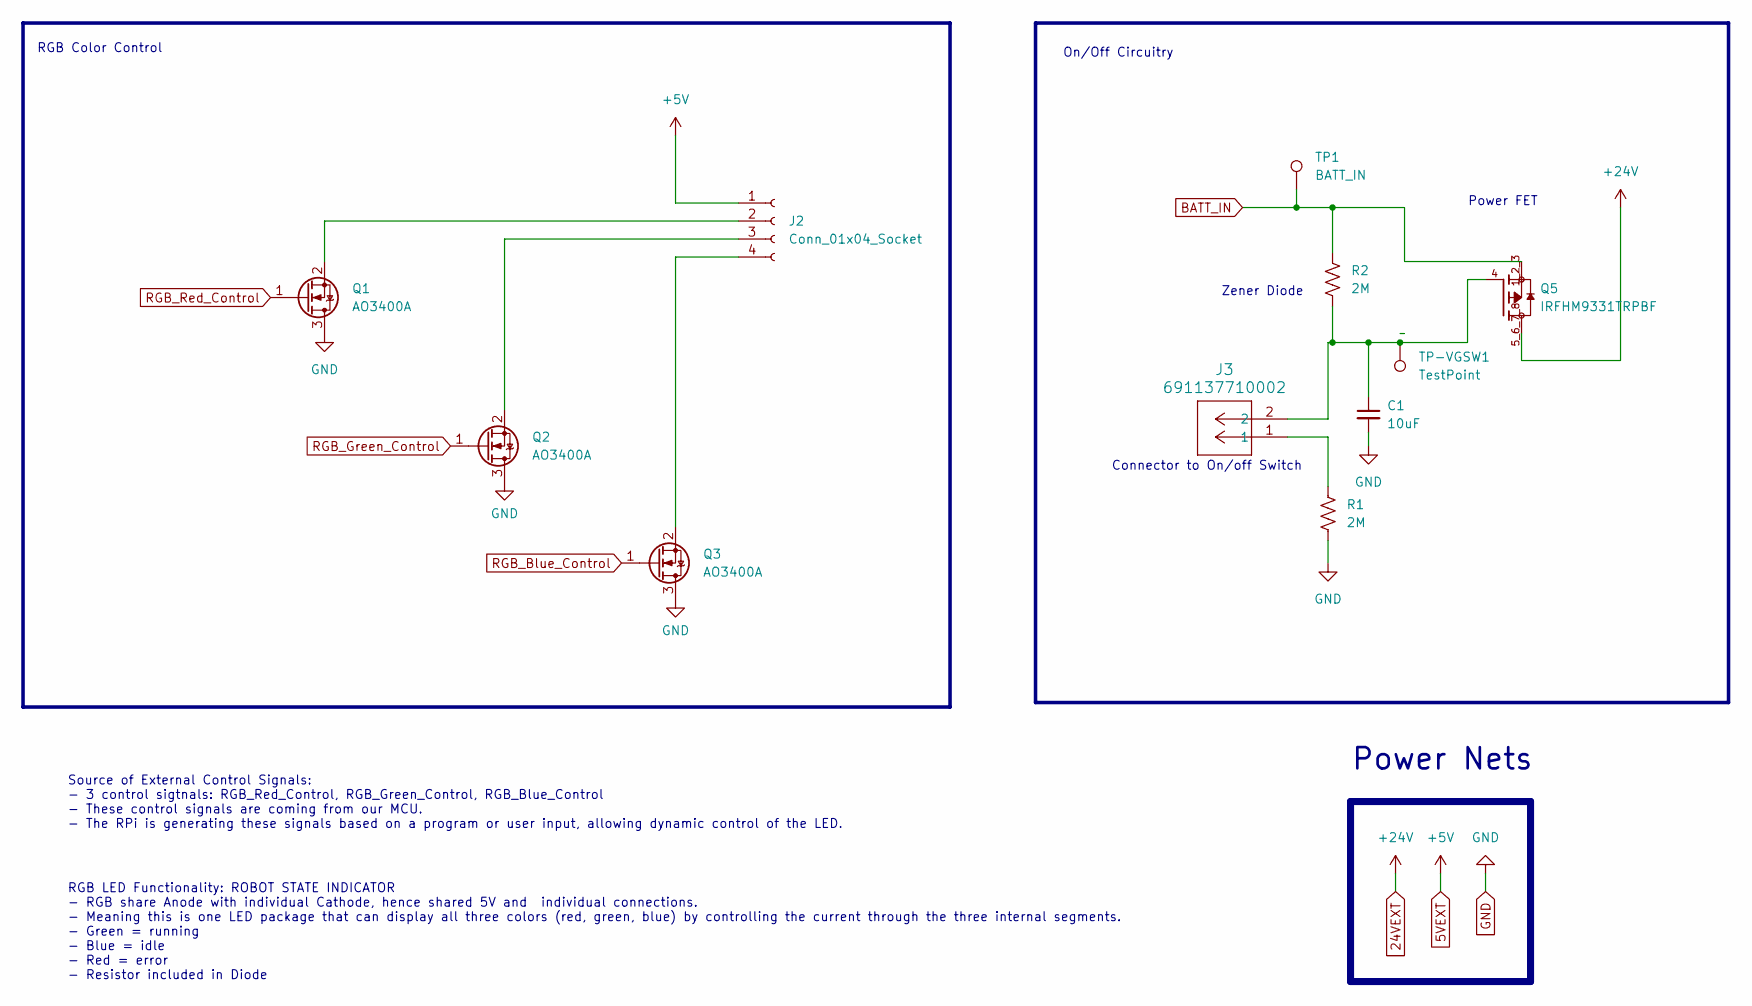
[picture p18: schematic cstar-io.kicad_sch]

Parts:
C1: 10uF; C_0805_2012Metric; LCSC C2190942
J2: Conn_01x04_Socket; EncoderConn; LCSC C566011
J3: 691137710002; 691137710002-2CONN; LCSC C3819953
Q1, Q2, Q3: AO3400A; RGB-FETS; LCSC C20917
Q5: IRFHM9331TRPBF; TRANS_IRFHM9331TRPBF; PARTREV December 16, 2013; LCSC C148156
R1, R2: 2M; R_0805_2012Metric; LCSC C114532
TP1: BATT_IN; TestPoint_Pad_D2.0mm
TP-VGSW1: TestPoint; TestPoint_Pad_D2.0mm

Connections:
5VEXT: J2.1; also elsewhere on the board
24VEXT: Q5.5_6_7_8; also elsewhere on the board
BATT_IN: Q5.1_2_3, R2.1, TP1.1; also elsewhere on the board
GND: C1.2, Q1.3 (D), Q2.3 (D), Q3.3 (D), R1.2; also elsewhere on the board
unnamed: C1.1, J3.2, Q5.4, R2.2, TP-VGSW1.1
unnamed: J2.2, Q1.2 (S)
unnamed: J2.3, Q2.2 (S)
unnamed: J2.4, Q3.2 (S)
unnamed: J3.1, R1.1
RGB_Blue_Control: Q3.1 (G); also elsewhere on the board
RGB_Green_Control: Q2.1 (G); also elsewhere on the board
RGB_Red_Control: Q1.1 (G); also elsewhere on the board

Notes on the sheet:
Zener Diode
RGB LED Functionality: ROBOT STATE INDICATOR - RGB share Anode with individual Cathode, hence shared 5V and individual connections. - Meaning this is one LED package that can display all three colors (red, green, blue) by controlling the current through the three internal segments. - Green = runnin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
Source of External Control Signals: - 3 control sigtnals: RGB_Red_Control, RGB_Green_Control, RGB_Blue_Control - These control signals are coming from our MCU. - The RPi is generating these signals based on a program or user input, allowing dynamic control of the LED.
Power FET
Connector to On/off Switch
On/Off Circuitry
RGB Color Control
Power Nets
