Car-V/CSTAR-capstone/PCB_Rev1/Main_Board_Rev1/Main_Board_Rev1.kicad_pcb

## KiCad design PCB_Rev1/Main_Board_Rev1/Main_Board_Rev1.kicad_pcb (continued)

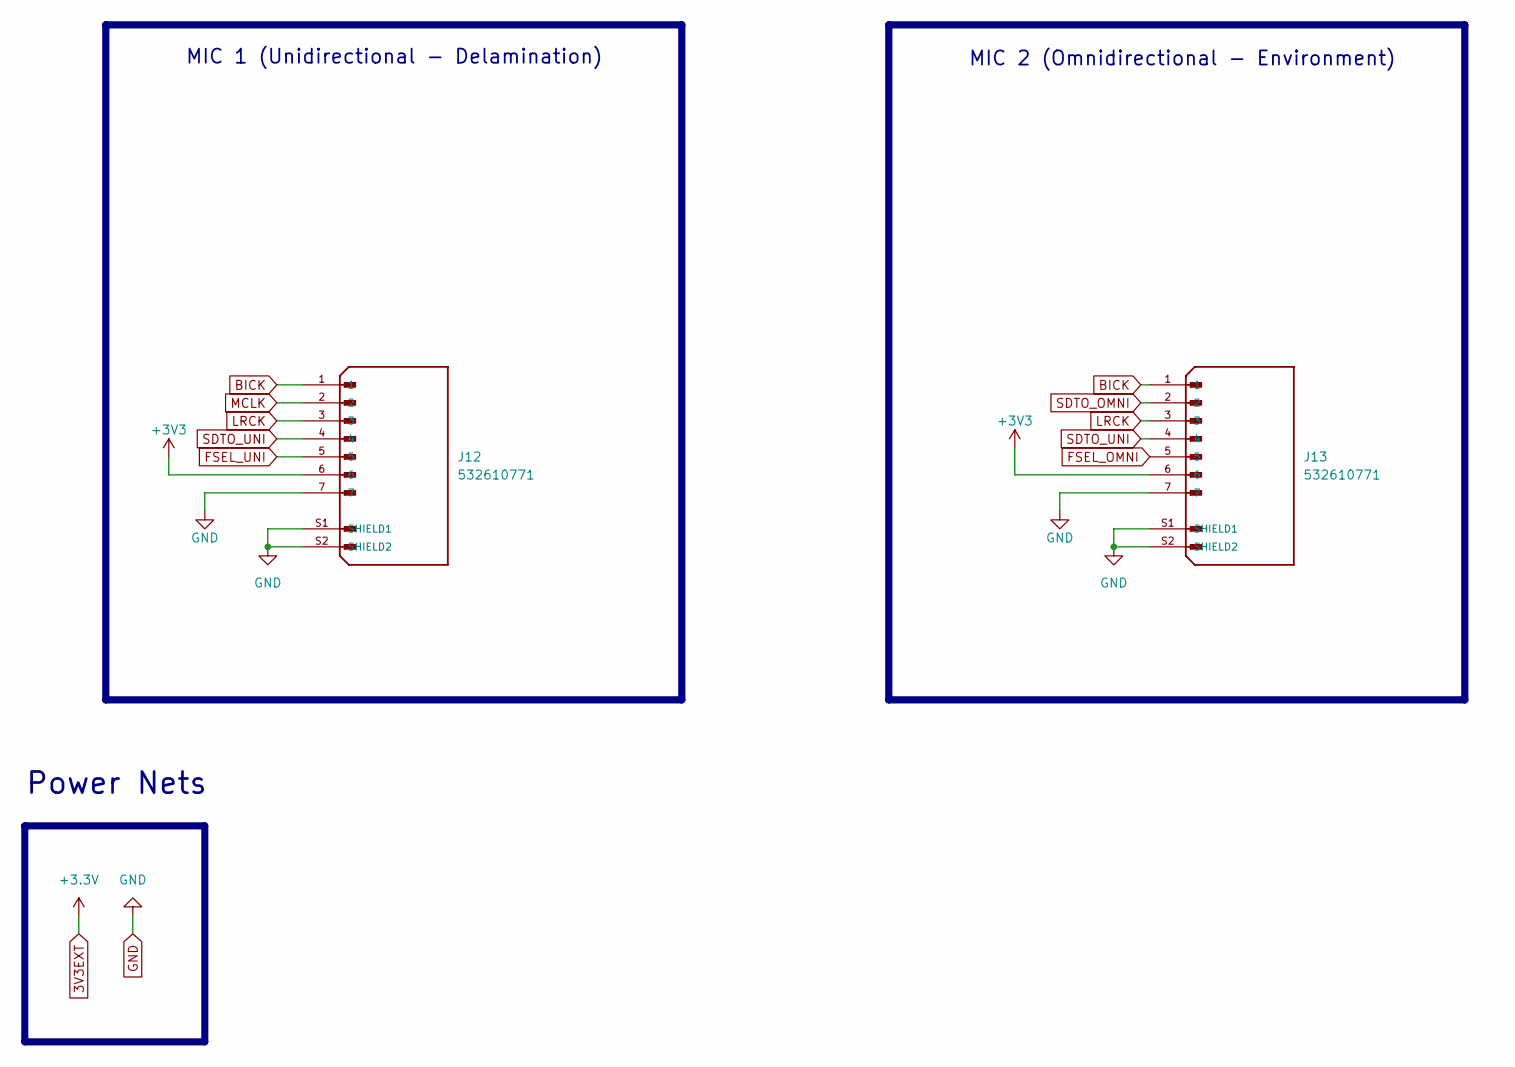
[picture p19: schematic cstar-audio.kicad_sch]

Parts:
J12, J13: 532610771; MOLEX_connector; PARTREV J; DigiKey_Part_Number WM7625TR-ND

Connections:
+3V3: J12.6, J13.6; also elsewhere on the board
BICK: J12.1, J13.1; also elsewhere on the board
FSEL_OMNI: J13.5; also elsewhere on the board
FSEL_UNI: J12.5; also elsewhere on the board
GND: J12.7, J12.S1 (SHIELD1), J12.S2 (SHIELD2), J13.7, J13.S1 (SHIELD1), J13.S2 (SHIELD2); also elsewhere on the board
LRCK: J12.3, J13.3; also elsewhere on the board
MCLK: J12.2; also elsewhere on the board
SDTO_OMNI: J13.2; also elsewhere on the board
SDTO_UNI: J12.4, J13.4

Notes on the sheet:
MIC 2 (Omnidirectional - Environment)
Power Nets
MIC 1 (Unidirectional - Delamination)

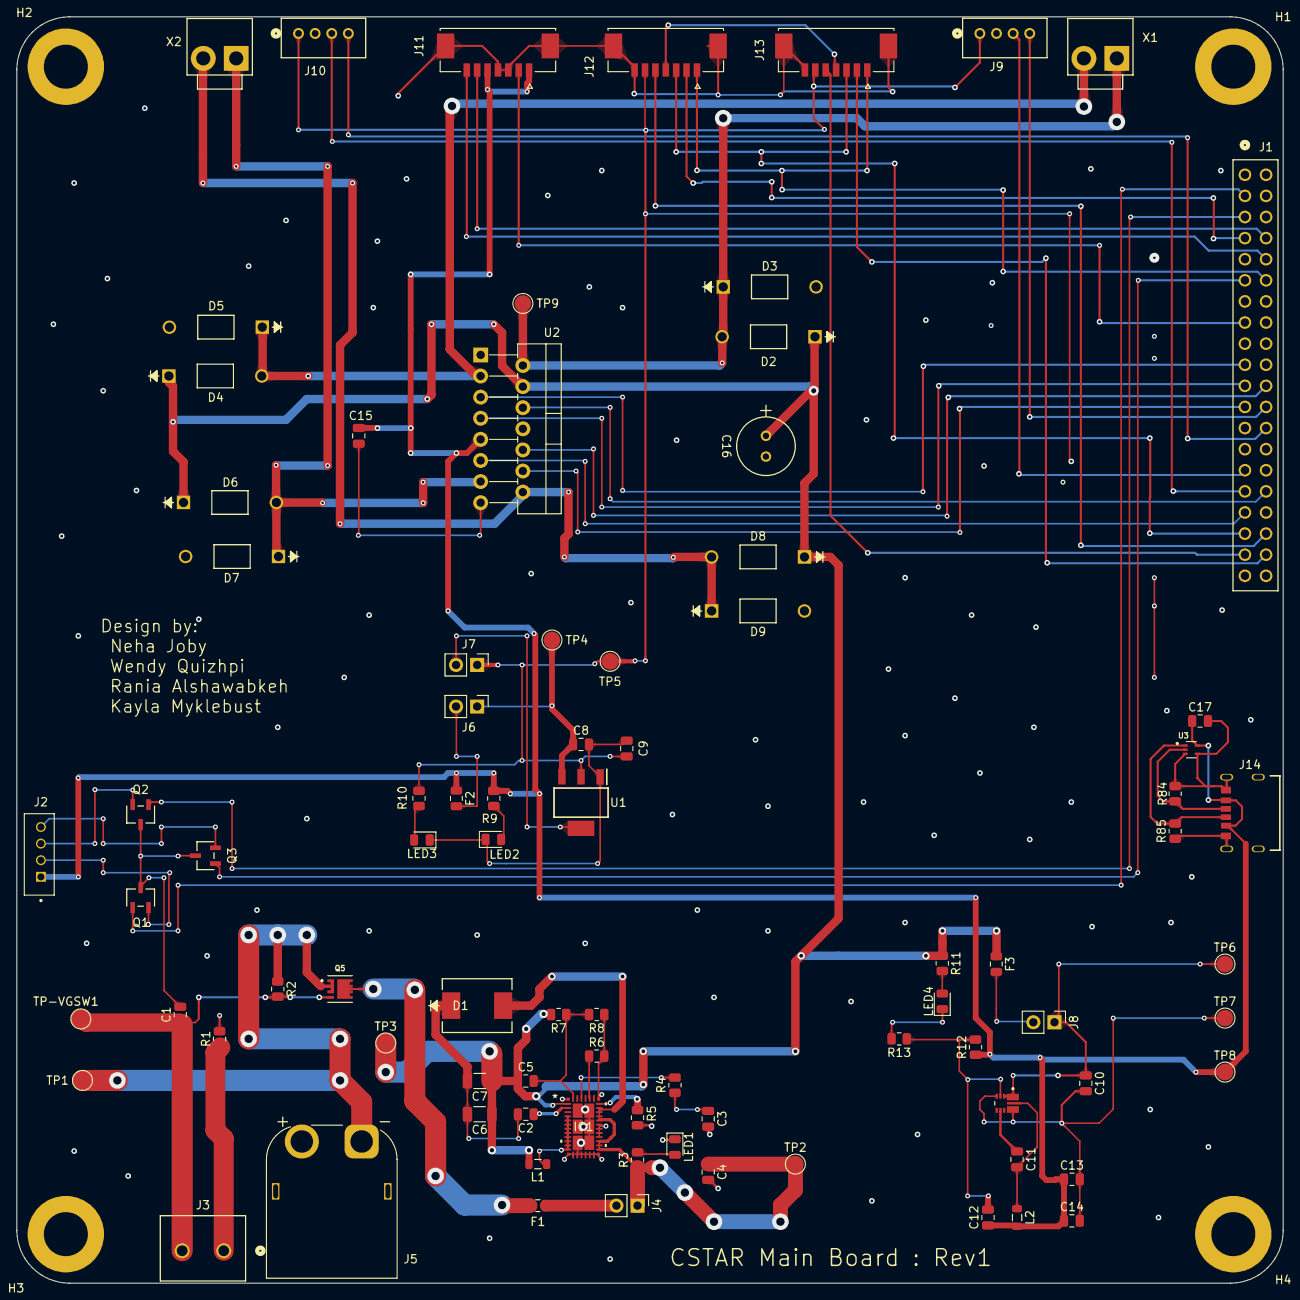
[picture p20: board Main_Board_Rev1.kicad_pcb from above]

Board: 4 copper layers, 152.4 x 152.4 mm, 89 parts (0 on the bottom side), 61 nets.
