Car-V/CSTAR-capstone/(commit log)

2025-01-12 Moving to CSTAR capstone
    [Main_Board_Rev1.kicad_sch, cstar-audio.kicad_sch, cstar-drive.kicad_sch, cstar-io.kicad_sch, cstar-lidar.kicad_sch, cstar-power.kicad_sch]
2025-01-12 Motor Driver
    Motor driver, encoder connections, and motor connections
    [cstar-drive.kicad_sch]
2025-01-12 Wendy's Mic schem changes
    [Mic_Board_Rev1.kicad_sch]
2025-01-12 Both Mic Board 1 and Mic Board 2 were created + updated
    [Mic_Board_Rev1.kicad_sch, Mic_Board_Unidirectional.kicad_pcb, Mic_Board_Unidirectional.kicad_sch]
2025-01-13 MicBoard Added to MainBoard
    [Mic_Board_Rev1.kicad_sch, Mic_Board_Unidirectional.kicad_sch, cstar-audio.kicad_sch]
2025-01-14 Schem changes made in BMS
    [cstar-power.kicad_sch]
2025-01-14 LDO component files imported
    [cstar-audio.kicad_sch, cstar-drive.kicad_sch, cstar-lidar.kicad_sch]
2025-01-14 LDO footprint assigned
    [cstar-audio.kicad_sch, cstar-lidar.kicad_sch, cstar-power.kicad_sch]
2025-01-14 Deleting PCB Layout
    errors in PCB layout
2025-01-15 All BMS footprints added
    [cstar-audio.kicad_sch, cstar-lidar.kicad_sch, cstar-power.kicad_sch]
2025-01-15 I/O footprints added
    [cstar-io.kicad_sch]
2025-01-15 Op-Amp, OmiDirectional, ADC footnotes
    [Omnidirectional.step]
2025-01-15 Header Connections FootPrint
2025-01-15 Footprints Update + Motor Drive Voltage Source Adjustments
2025-01-15 PCB Layout started
    [Main_Board_Rev1.kicad_pcb]
2025-01-15 Driver Schematic Update
    Vss / Vs and decoupling capacitor updates
    [cstar-drive.kicad_sch]
2025-01-15 Audio schem file deleted
    [Main_Board_Rev1.kicad_sch, cstar-audio.kicad_sch]
2025-01-15 Passives footprints changed
    [cstar-drive.kicad_sch]
2025-01-15 RPi Connector Footprints
2025-01-15 Added new footprints
    [Main_Board_Rev1.kicad_sch, cstar-drive.kicad_sch, cstar-io.kicad_sch, cstar-power.kicad_sch]
2025-01-15 more footprints changes
    [cstar-drive.kicad_sch, cstar-io.kicad_sch, cstar-power.kicad_sch]
2025-01-15 diodes footprints added
    [cstar-drive.kicad_sch]
2025-01-15 more footprints assigned
    [cstar-drive.kicad_sch, cstar-power.kicad_sch]
2025-01-15 FOOTPRINTS COMPLETE!!!!!
    [Main_Board_Rev1.kicad_pcb, cstar-io.kicad_sch, cstar-power.kicad_sch]
2025-01-15 Relative Path for FP Lib
    [Omnidirectional.step]
2025-01-15 Some schem changes to BMS
    [cstar-power.kicad_sch]
2025-01-15 Some schem changes in I/O
    [cstar-io.kicad_sch]
2025-01-15 PCB maybe
2025-01-15 Micboard Omni PCB
    [Mic_Board_Rev1.kicad_pcb, Mic_Board_Rev1.kicad_sch]
2025-01-15 Edge cuts complete (borders + holes)
    [Main_Board_Rev1.kicad_pcb, Main_Board_Rev1.kicad_sch]
2025-01-16 board stackup complete
    [Main_Board_Rev1.kicad_pcb]
2025-01-16 moved some components
    [Main_Board_Rev1.kicad_pcb]
2025-01-16 more component changes
    [Main_Board_Rev1.kicad_pcb]
2025-01-16 Motor Drive Adjustment and Added Footprint for Polarized Cap
    [cstar-drive.kicad_sch]
2025-01-16 BMS component org done
    [Main_Board_Rev1.kicad_pcb]
2025-01-16 Organized Motor Drive Components
    [Main_Board_Rev1.kicad_pcb]
2025-01-16 Power nets (local + global) created
    [cstar-power.kicad_sch]
2025-01-16 Renamed J1 Connector MicBoard
    [Mic_Board_Unidirectional.kicad_sch]
2025-01-16 mounting hole labeled
    [Main_Board_Rev1.kicad_sch]
2025-01-16 Audio subsystem re-created
    [Main_Board_Rev1.kicad_sch, cstar-audio.kicad_sch, cstar-drive.kicad_sch]
2025-01-16 audio file finalized
    [Main_Board_Rev1.kicad_sch, cstar-audio.kicad_sch]
2025-01-16 Revert "audio file finalized"
    This reverts commit 478d881cdb306273da0e0f1ea37dd6a2880d93a8.
    [Main_Board_Rev1.kicad_sch, cstar-audio.kicad_sch]
2025-01-16 Revert "Audio subsystem re-created"
    This reverts commit 6dc47edf88eae56b01440ce5f2dfd5da155ce597.
    [Main_Board_Rev1.kicad_sch, cstar-audio.kicad_sch, cstar-drive.kicad_sch, cstar-lidar.kicad_sch]
2025-01-16 Updated Audio Schematic
    [cstar-audio.kicad_sch, cstar-lidar.kicad_sch]
2025-01-16 Added Footprints + Updated Layout for Audio Connectors
    [Main_Board_Rev1.kicad_pcb, cstar-audio.kicad_sch]
2025-01-16 Power nets updated in all schematics
    [cstar-audio.kicad_sch, cstar-drive.kicad_sch, cstar-io.kicad_sch, cstar-lidar.kicad_sch]
2025-01-16 Connections to RPi GPIO Pins + Eliminating Errors from Layout
    Global net connections made from RPi GPIO pins.
    Error for mounting hole corrected -> mounting hole symbol imported into schematic and correct footprint assigned.
    Warnings for J10, J11, J12 connectors resolved- imported footprint for the connector from online (error in the one imported from KiCAD libraries with pins S1 and S2 labeled as MP in the footprint)
    [Main_Board_Rev1.kicad_pcb, Main_Board_Rev1.kicad_sch, cstar-audio.kicad_sch, cstar-drive.kicad_sch, cstar-io.kicad_sch, cstar-lidar.kicad_sch]
2025-01-17 Multiple Mounting Holes Added + GPIO Connections Added for RGB
    [Main_Board_Rev1.kicad_pcb, Main_Board_Rev1.kicad_sch]
2025-01-17 mounting holes set
    [Main_Board_Rev1.kicad_pcb, Main_Board_Rev1.kicad_sch]
2025-01-17 I/O component placement complete
    [Main_Board_Rev1.kicad_pcb]
2025-01-17 Lidar + Audio CP complete
    [Main_Board_Rev1.kicad_pcb]
2025-01-17 motor drive CP complete
    [Main_Board_Rev1.kicad_pcb]
2025-01-17 Power Update
    [Main_Board_Rev1.kicad_pcb]
2025-01-17 more CP changes
    [Main_Board_Rev1.kicad_pcb]
2025-01-17 more CP commits
    [Main_Board_Rev1.kicad_pcb]
2025-01-18 Component Placement complete
    [Main_Board_Rev1.kicad_pcb]
2025-01-18 Lidar routing complete
    [Main_Board_Rev1.kicad_pcb]
2025-01-18 routing attempt
    [Main_Board_Rev1.kicad_pcb]
2025-01-18 J12 connector routing
    [Main_Board_Rev1.kicad_pcb]
2025-01-19 Added routing
    [Main_Board_Rev1.kicad_pcb]
2025-01-19 some more routing
    [Main_Board_Rev1.kicad_pcb]
2025-01-19 TP for Motor Drive + U2 Routing
    [Main_Board_Rev1.kicad_pcb, cstar-drive.kicad_sch]
2025-01-19 Routing U2 Enable Pin
    [Main_Board_Rev1.kicad_pcb]
2025-01-20 More routing
    [Main_Board_Rev1.kicad_pcb]
2025-01-20 Micboard pcb
    [Mic_Board_Rev1.kicad_pcb, Mic_Board_Unidirectional.kicad_pcb, Mic_Board_Unidirectional.kicad_sch]
2025-01-20 Mounting holes?
    [Mic_Board_Unidirectional.kicad_pcb, Mic_Board_Unidirectional.kicad_sch]
2025-01-20 accidently clicked
    hello
    [Mic_Board_Unidirectional.kicad_pcb]
2025-01-21 Mic Board Mounting Hole Placement + Fillets + Eliminating Errors
    Placed mounting holes, added fillets to the corners of the pcb, and eliminated errors by using correct connector in place of the microphone in the schematic + layout
    [Mic_Board_Unidirectional.kicad_pcb, Mic_Board_Unidirectional.kicad_sch]
2025-01-21 mic board component adjustments
    [Mic_Board_Unidirectional.kicad_pcb]
2025-01-21 Mic routing
    [Mic_Board_Unidirectional.kicad_pcb]
2025-01-22 Ground Plane + Mic Board Adjustments
    [Main_Board_Rev1.kicad_pcb, Mic_Board_Unidirectional.kicad_pcb]
2025-01-22 some routing
    [Main_Board_Rev1.kicad_pcb]
2025-01-22 Uni Delam Rev 1 Complete ?
    [Mic_Board_Unidirectional.kicad_pcb]
2025-01-22 Mic board works!!
2025-01-22 main board routing
    [Main_Board_Rev1.kicad_pcb]
2025-01-22 Mainboard finished traces
    [Main_Board_Rev1.kicad_pcb]
2025-01-22 how do you polygon
    [Main_Board_Rev1.kicad_pcb]
2025-01-22 poly shit
    [Main_Board_Rev1.kicad_pcb]
2025-01-22 added new power fet footprint
2025-01-22 fixed soldering bridge issue
    [Main_Board_Rev1.kicad_pcb, cstar-io.kicad_sch]
2025-01-22 new power fet
2025-01-22 GND net to M5 holes
    [Main_Board_Rev1.kicad_pcb, Main_Board_Rev1.kicad_sch, cstar-io.kicad_sch]
2025-01-22 another FET
2025-01-22 final touches... not rlly
    [Main_Board_Rev1.kicad_pcb, cstar-io.kicad_sch]
2025-01-22 Added Old Footprint
2025-01-22 Updated Footprint + Symbol for FET
    [Main_Board_Rev1.kicad_pcb, cstar-io.kicad_sch]
2025-01-22 Yay Kayla Fixed
    omg kayla youre so awsome thank you for saving us
    [Main_Board_Rev1.kicad_pcb]
2025-01-22 Grounded Mic Board Mounting Holes
    [Mic_Board_Unidirectional.kicad_pcb, Mic_Board_Unidirectional.kicad_sch]
2025-01-22 Mounting Hole Grounding
    [Main_Board_Rev1.kicad_pcb]
2025-01-22 Mic Board Setup Adjustments
    [Mic_Board_Unidirectional.kicad_pcb]
2025-01-22 trace widths + teardrops
    [Main_Board_Rev1.kicad_pcb]
2025-01-22 some chanegufghjikjhg
    [Main_Board_Rev1.kicad_pcb]
2025-01-22 Mic Board Setup Changes
    [Mic_Board_Unidirectional.kicad_pcb]
2025-01-22 Updates to routing
    [Main_Board_Rev1.kicad_pcb]
2025-01-22 sOOOO many changes
    [cstar-audio.kicad_sch, cstar-drive.kicad_sch, cstar-lidar.kicad_sch, cstar-power.kicad_sch]
2025-01-23 Trace width adjustments
    [Main_Board_Rev1.kicad_pcb]
2025-01-23 More routing/power planes
    [Main_Board_Rev1.kicad_pcb]
2025-01-23 Micboard Changes
    [Mic_Board_Unidirectional.kicad_pcb]
2025-01-23 JLC ordering file created
    [Main_Board_Rev1-B_Cu.gbl, Main_Board_Rev1-B_Mask.gbs, Main_Board_Rev1-B_Paste.gbp, Main_Board_Rev1-B_Silkscreen.gbo, Main_Board_Rev1-Edge_Cuts.gm1, Main_Board_Rev1-F_Cu.gtl, Main_Board_Rev1-F_Mask.gts, Main_Board_Rev1-F_Paste.gtp]
2025-01-23 MicBoard silkscreen updated
    [Mic_Board_Unidirectional.kicad_pcb]
2025-01-23 more MicBoard re-routing
    [Mic_Board_Unidirectional.kicad_pcb]
2025-01-23 Mic Board silkscreen complete
    [Mic_Board_Unidirectional.kicad_pcb]
2025-01-23 Main Board silkscreen changes
    [Main_Board_Rev1.kicad_pcb]
2025-01-24 Layout Basic Cleanup
    [Main_Board_Rev1.kicad_pcb]
2025-01-24 Sprinkled in GND vias
    [Main_Board_Rev1.kicad_pcb]
2025-01-24 Deleted massive PWR plane- need to add separate planes for each pwr rail
    [Main_Board_Rev1.kicad_pcb]
2025-01-24 ESD Protection for USB Connector
    [Main_Board_Rev1.kicad_pcb, cstar-power.kicad_sch]
2025-01-24 Fixed DRC errors
    [Main_Board_Rev1.kicad_pcb]
2025-01-24 Via sizes increased
    [Main_Board_Rev1.kicad_pcb]
2025-01-24 5V traces increased to 0.7mm
    [Main_Board_Rev1.kicad_pcb]
2025-01-24 12V traces widths increased 1.016
    [Main_Board_Rev1.kicad_pcb, cstar-io.kicad_sch]
2025-01-24 Motor outputs traces were increased 1.016
    [Main_Board_Rev1.kicad_pcb]
2025-01-24 Motor Drive Implementation
    TO DO:
    - figure out full functionality and data flow with encoders and motors
    - test on rpi
    - check logic
2025-01-24 12V traces increased 2.54
    [Main_Board_Rev1.kicad_pcb]
2025-01-24 Name updates
    Just to distinguish between a motor direction versus the whole bot's direction
2025-01-24 PCB routing done
    [Main_Board_Rev1.kicad_pcb]
2025-01-25 Audio Connector Pins
    [Main_Board_Rev1.kicad_sch, Mic_Board_Unidirectional.kicad_pcb, Mic_Board_Unidirectional.kicad_sch, cstar-audio.kicad_sch]
2025-01-25 connections for gpio and micboards
    [Mic_Board_Rev1.kicad_pcb, Mic_Board_Rev1.kicad_sch, Mic_Board_Unidirectional.kicad_sch]
2025-01-25 Connections Adjustments
    [Main_Board_Rev1.kicad_pcb, Main_Board_Rev1.kicad_sch, Mic_Board_Unidirectional.kicad_pcb, Mic_Board_Unidirectional.kicad_sch, cstar-audio.kicad_sch]
2025-01-26 Re Routing Rpi
    [Main_Board_Rev1.kicad_pcb]
2025-01-26 RPi Connections & Errors Corrected
    [Main_Board_Rev1.kicad_pcb]
2025-01-26 new mic boards added
    [Mic_Board_Omni_NEW.kicad_pcb, Mic_Board_Omni_NEW.kicad_sch, Mic_Board_Rev1.kicad_pcb, Mic_Board_Rev1.kicad_sch, Mic_Board_Unidirectional.kicad_pcb, Mic_Board_Unidirectional.kicad_sch]
2025-01-26 Micboard Done with traces
    [Main_Board_Rev1.kicad_pcb, cstar-audio.kicad_sch]
2025-01-26 Running Motor Test
2025-01-26 UNI CSV DONE
    [Mic_Board_Unidirectional.csv]
2025-01-26 LCSC + CSV changes
    [Main_Board_Rev1.kicad_pcb, Main_Board_Rev1.kicad_sch, Main_Board_Rev1_CSV.csv, cstar-audio.kicad_sch, cstar-drive.kicad_sch, cstar-io.kicad_sch, cstar-lidar.kicad_sch, cstar-power.kicad_sch]
2025-01-26 MICBOARD OMNI CSV DONE
    [Mic_Board_Omni_NEW.csv, Mic_Board_Omni_NEW.kicad_pcb, Mic_Board_Omni_NEW.kicad_sch]
2025-01-26 Centroid CSV for Main Board
    [Main_Board_Rev1-bottom-pos.csv, Main_Board_Rev1-top-pos.csv]
2025-01-26 Micboard Centroid FIles DONE
    [Mic_Board_Omni_NEW-bottom-pos.csv, Mic_Board_Omni_NEW-top-pos.csv, Mic_Board_Unidirectional-bottom-pos.csv, Mic_Board_Unidirectional-top-pos.csv]
2025-01-27 All gerber, BOM, + p&p files created
    [Main_Board_Rev1-B_Cu.gbl, Main_Board_Rev1-B_Mask.gbs, Main_Board_Rev1-B_Paste.gbp, Main_Board_Rev1-B_Silkscreen.gbo, Main_Board_Rev1-Edge_Cuts.gm1, Main_Board_Rev1-F_Cu.gtl, Main_Board_Rev1-F_Mask.gts, Main_Board_Rev1-F_Paste.gtp]
2025-01-29 Motor accel/decel, LiDAR beginnings
2025-01-29 Assumed that duty cycle of one motor will always match the other, cleanup
2025-01-29 Also made PWM_Hz static, see prev. commits if we want to make this members non-static
2025-02-07 NEW ROS PACKAGES
    [bumper.urdf.xacro, camera_bracket.urdf.xacro, caster.urdf.xacro, common_properties.urdf.xacro, create3.urdf.xacro, depot.sdf, gz_waffle.sdf.xacro, gz_waffle_gps.sdf.xacro]
2025-02-09 Bandpass Filter Function
2025-02-10 Added input reading test case
2025-02-12 PID.py was created + Motor.py was updated w PID functions
2025-02-12 Updated Motor_Drive.py w PID
2025-02-12 Minor updates made to Motor_Drive_Manager.py
2025-02-19 begin adding odometry functions
2025-02-24 Motor control test code completed
2025-03-12 encoder files added
2025-03-12 Encoder.cpp and Encoder.h files updated to work w RPi
2025-03-12 encoder files updated
2025-03-23 Encoder Not Quaternion
2025-03-23 Edits to EncoderRos
2025-03-24 Working Encoder Node, need to test w GPIO
2025-03-30 updated pwm
2025-03-30 pwm 65
2025-03-30 pwm 60 50
2025-03-30 pwm 65 50
2025-03-30 pwm 65 45
2025-03-30 pwm 35 55
2025-03-30 pwm 55 40
2025-03-30 Filter Updates & Audio Manager Updates
2025-03-30 pwm 30 45
2025-03-30 pwm 30 40
2025-03-30 encoder stuff
2025-03-31 odometry update
    dis bish
2025-03-31 setting up pid
2025-04-14 Added audio driver attempt and test scripts
